SimonKohler88/esl1_fpga_fir/README.md

# esl1_fpga_fir
Configurable FIR for FPGA
