SimonKohler88/esl1_fpga_fir/hw/datasheets/pinout-modulo-esp.png

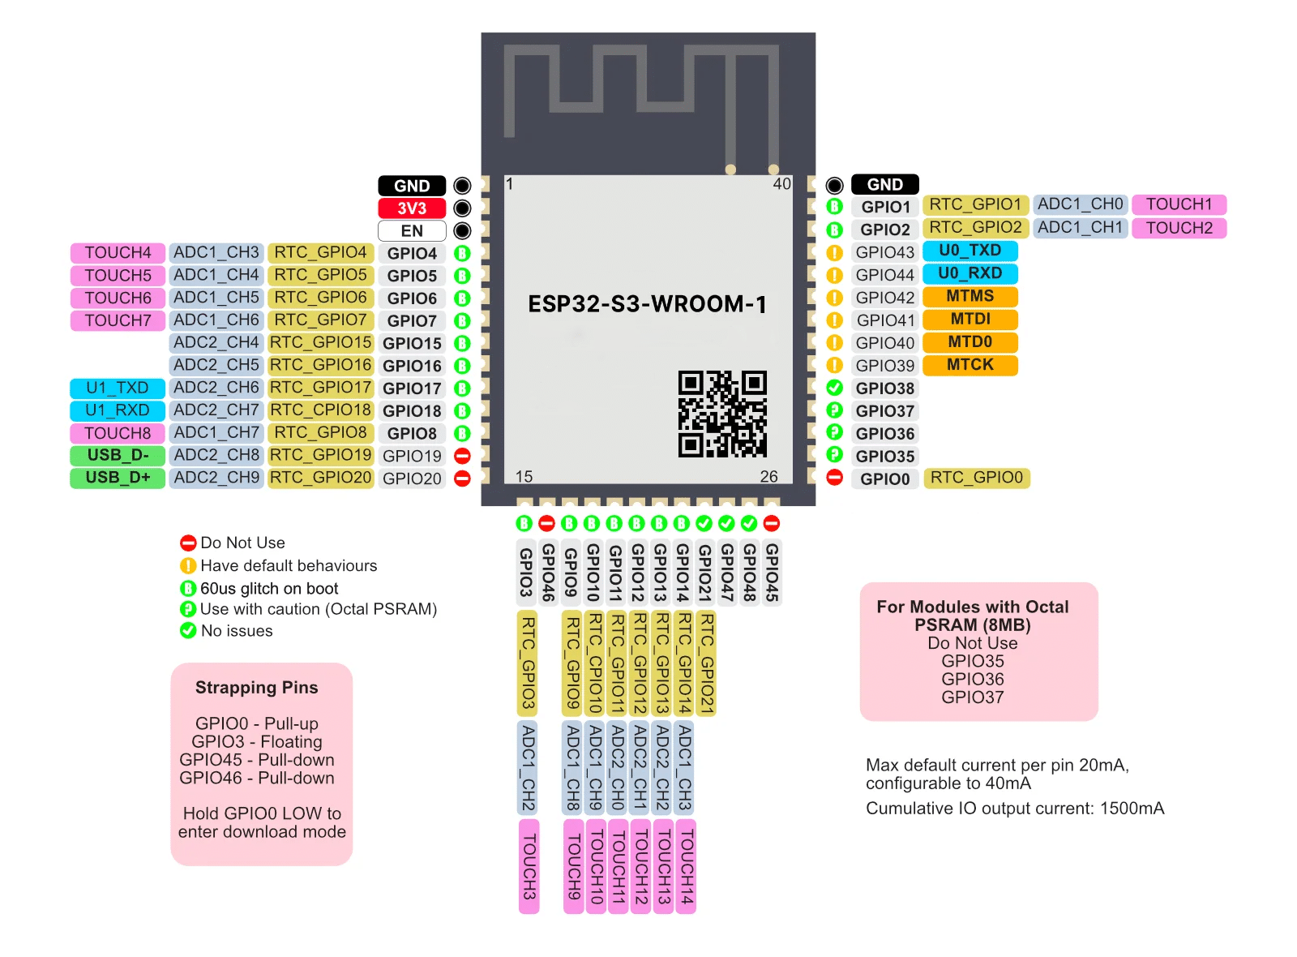
hw/datasheets/pinout-modulo-esp.png
