SimonKohler88/esl1_fpga_fir/pictures/Bode_3kHz_LP_FIR_Koeff.jpg

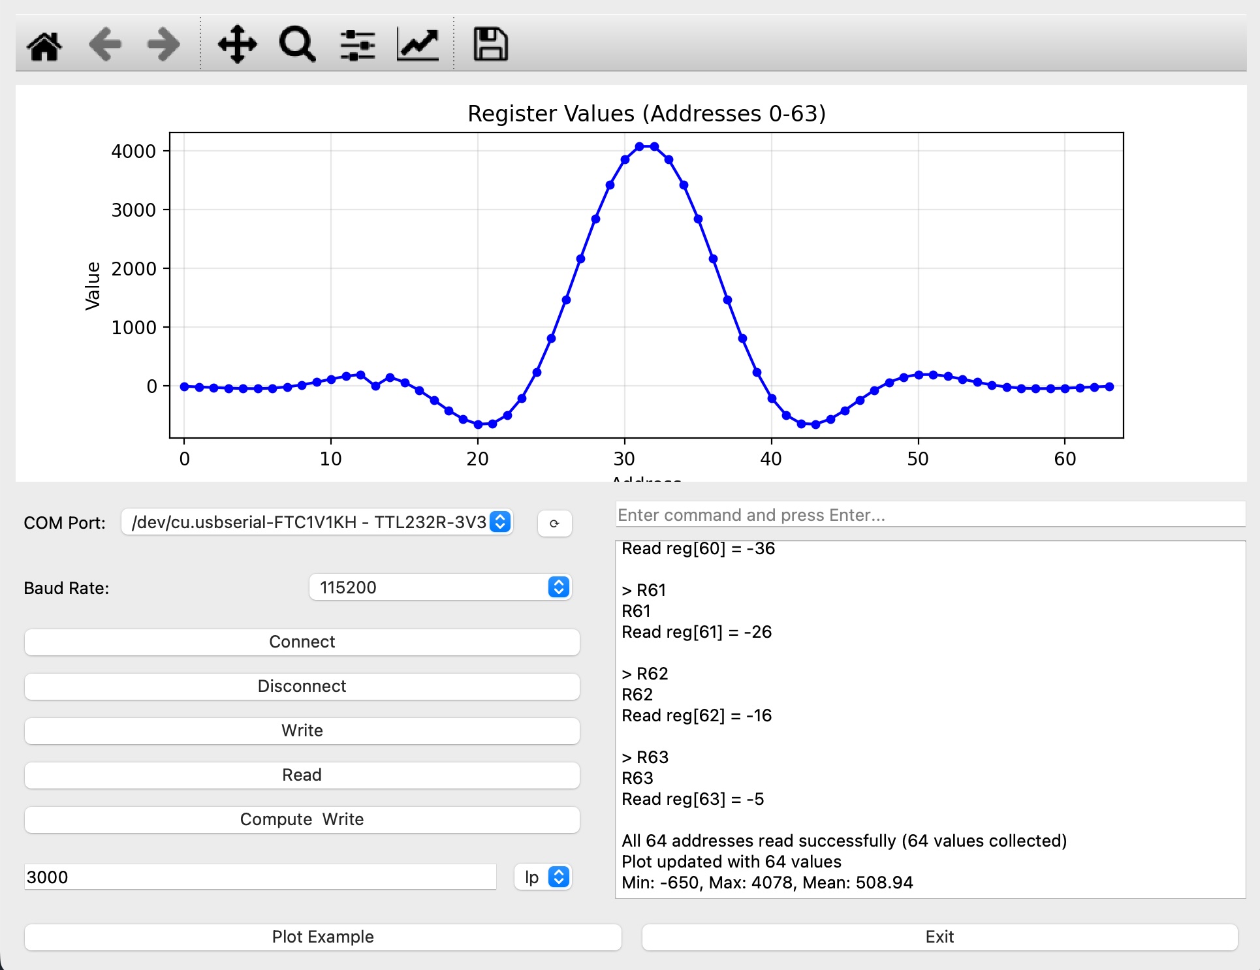
pictures/Bode_3kHz_LP_FIR_Koeff.jpg
