SimonKohler88/esl1_fpga_fir/pictures/Bode_10Hz_20kHz_2.png

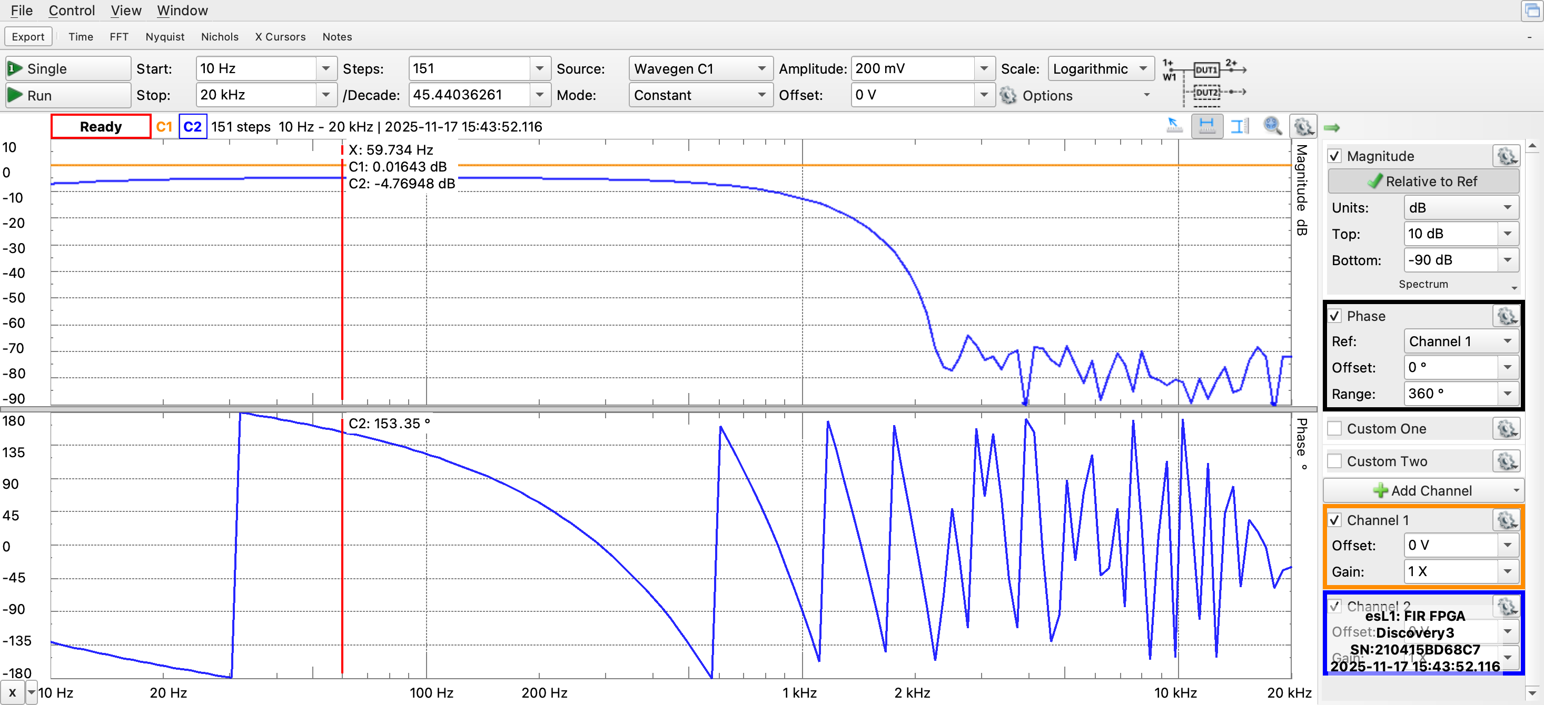
pictures/Bode_10Hz_20kHz_2.png
