SimonKohler88/esl1_fpga_fir/pictures/Bode_10Hz_20kHz_2_ FIR_Koeff.png

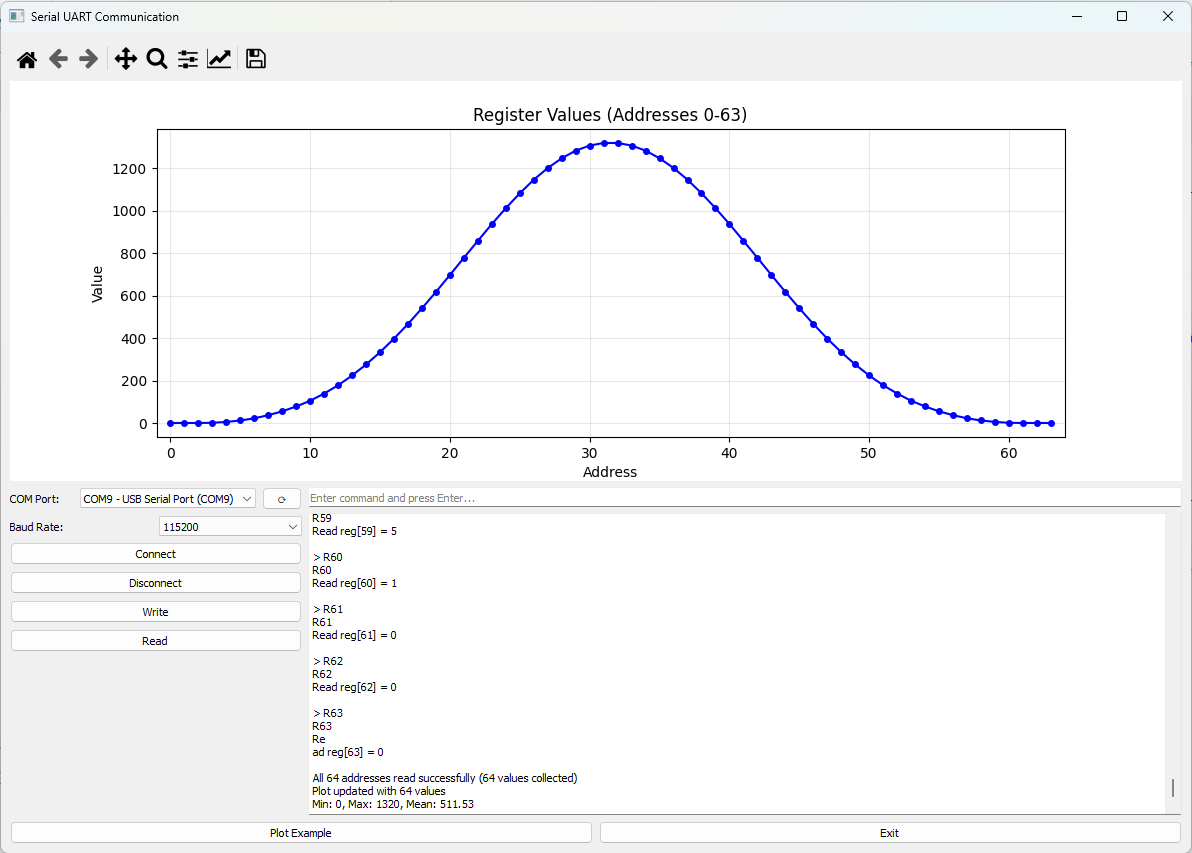
pictures/Bode_10Hz_20kHz_2_ FIR_Koeff.png
