SimonKohler88/esl1_fpga_fir/pictures/Coefficients_2kHz_LP.png

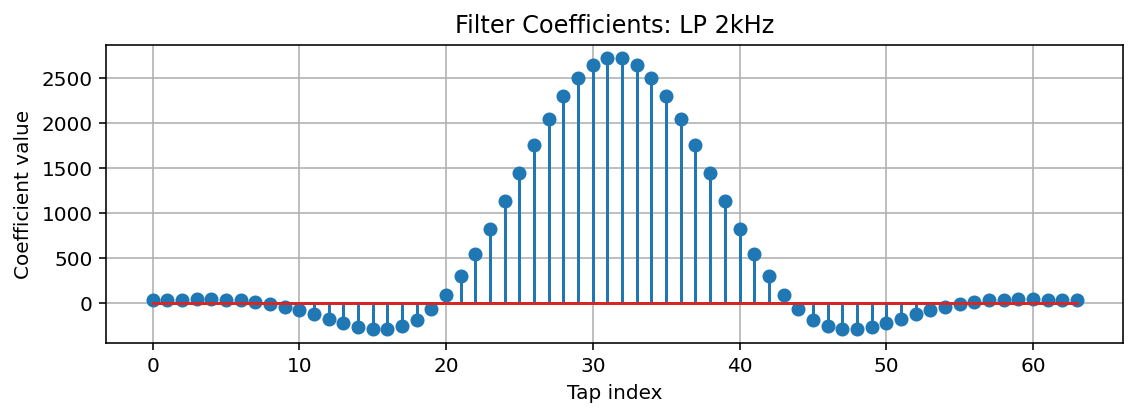
pictures/Coefficients_2kHz_LP.png
