SimonKohler88/esl1_fpga_fir/pictures/Coefficients_3kHz_LP.png

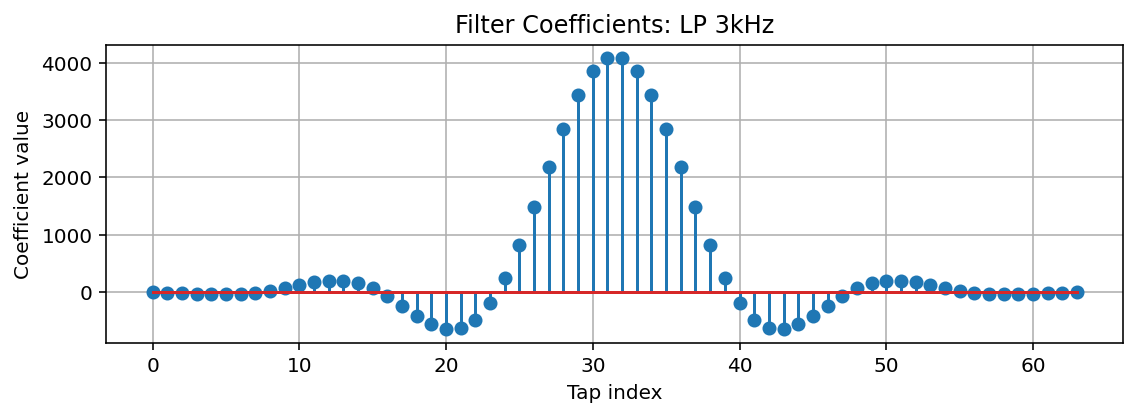
pictures/Coefficients_3kHz_LP.png
