SimonKohler88/esl1_fpga_fir/pictures/Magnitude_2kHz_LP.png

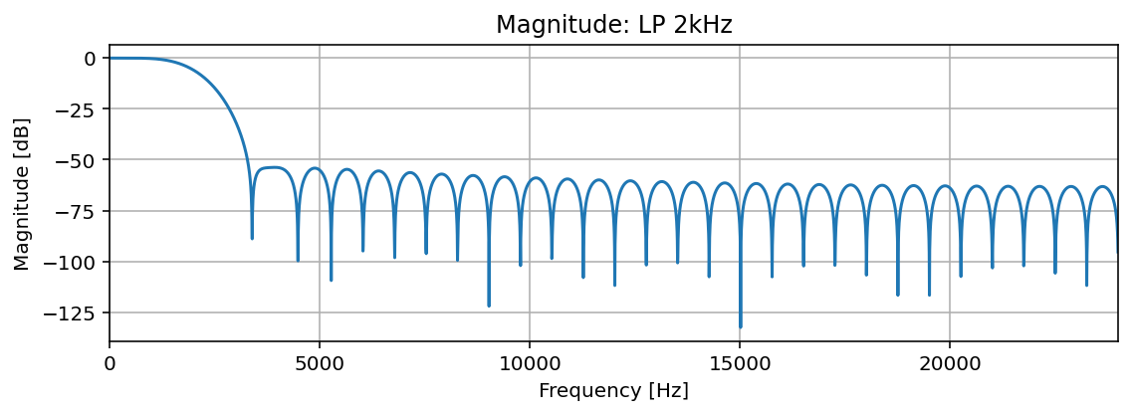
pictures/Magnitude_2kHz_LP.png
