SimonKohler88/esl1_fpga_fir/pictures/Magnitude_3kHz_LP.png

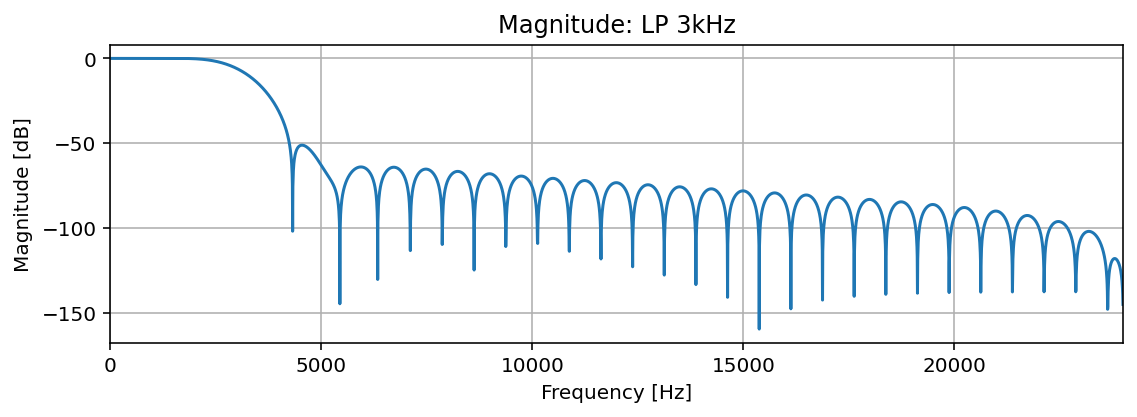
pictures/Magnitude_3kHz_LP.png
