SimonKohler88/esl1_fpga_fir/pictures/Phase_2kHz_LP.png

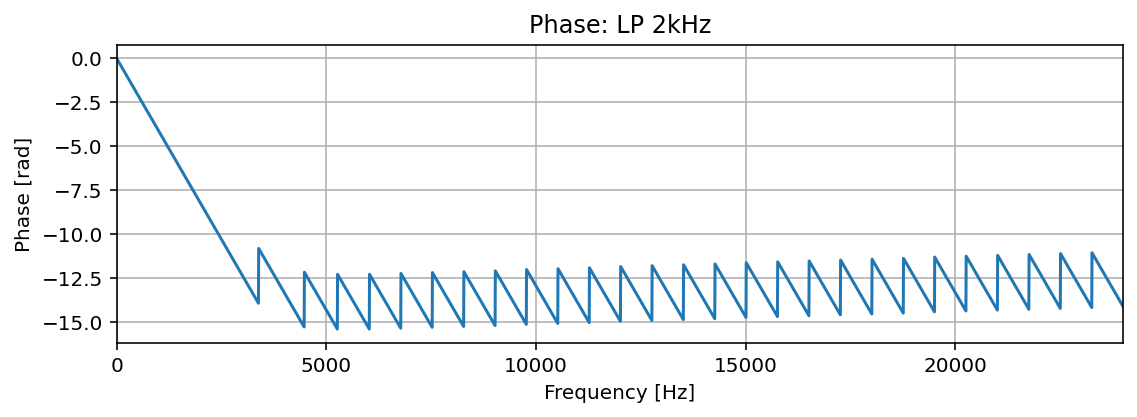
pictures/Phase_2kHz_LP.png
