SimonKohler88/esl1_fpga_fir/pictures/Phase_3kHz_LP.png

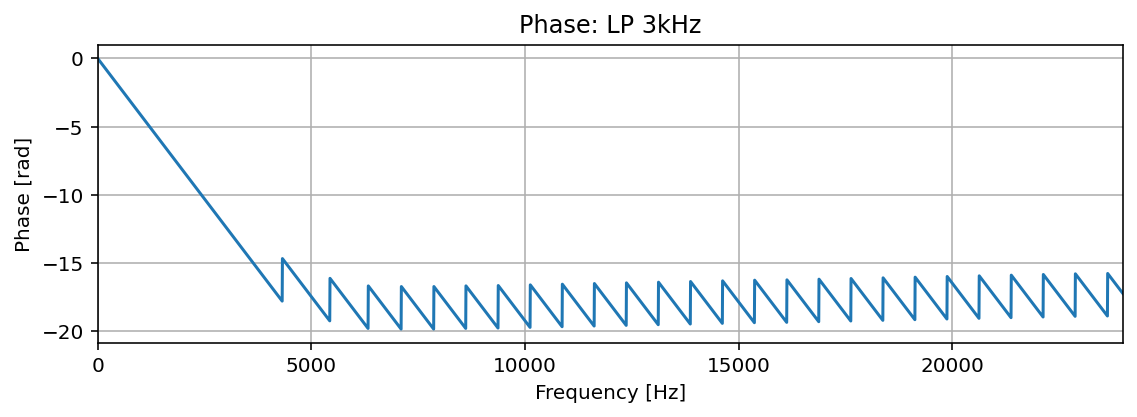
pictures/Phase_3kHz_LP.png
