SimonKohler88/esl1_fpga_fir/teros_doku/dependency_diagram.jpg

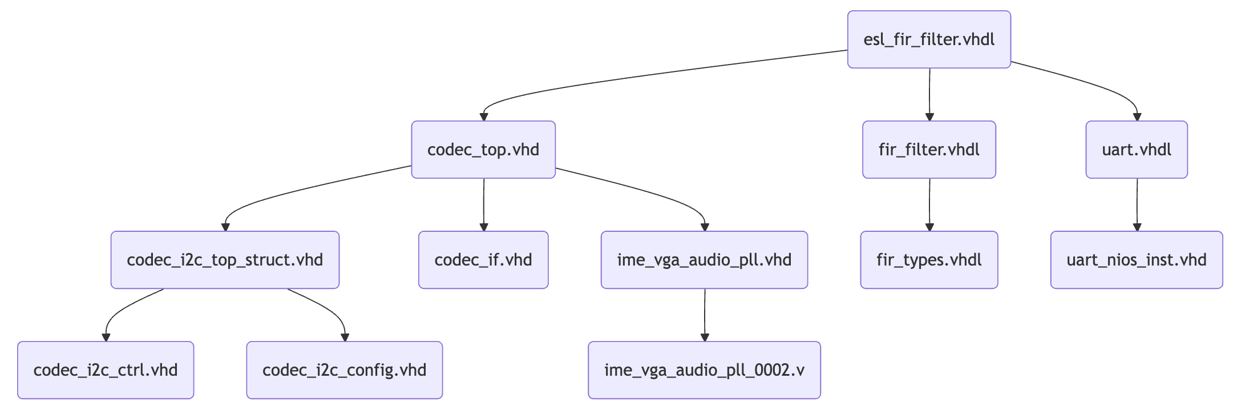
teros_doku/dependency_diagram.jpg
