SimonKohler88/esl1_fpga_fir/hw/kicad/bom.xlsx

 |  |  |  | Web | Anzahl
 | Dgikey | mouser
MCU | 5407-ESP32-S3-WROOM-1-N16CT-ND | 356-ESP32S3WROOM1N16 | ESP32-S3-WROOM-1-N16 | https://www.digikey.ch/de/products/detail/espressif-systems/ESP32-S3-WROOM-1-N16/16162647 | 1
ADC |  | 595-ADS7883SBDBVT | ADS7883 | https://www.mouser.ch/ProductDetail/Texas-Instruments/ADS7883SBDBVT?qs=iW8OfOTwbwNSwjtnxxv63g%3D%3D | 1
DAC |  | 926-DAC122S085CIMMNO | DAC122S085CIMMNO | https://www.mouser.ch/ProductDetail/Texas-Instruments/DAC122S085CIMM-NOPB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 | 1
inout opamp | 505-AD8671ARZ-ND | 584-AD8671ARZ-R7 | AD8671ARZ | https://www.digikey.ch/de/products/detail/analog-devices-inc/AD8671ARZ/751202 | 2
tp opamp | LM6134BIMX/NOPBCT-ND | 926-LM6134BIMX/NOPB | LM6134BIMX/NOPB | https://www.digikey.ch/de/products/detail/texas-instruments/LM6134BIMX-NOPB/334884 | 2
vref demux | NC7SB3157P6XCT-ND | 512-NC7SB3157P6X | NC7SB3157P6X | https://www.digikey.ch/de/products/detail/onsemi/NC7SB3157P6X/412875 | 1
komparator | 296-TLV9022DRCT-ND | 595-TLV9022DR | TLV9022DR | https://www.digikey.ch/de/products/detail/texas-instruments/TLV9022DR/13535468 | 1
mode mux | 296-14271-1-ND | 595-CD4051BM96 | CD4051BM96 | https://www.digikey.ch/de/products/detail/texas-instruments/CD4051BM96/528372 | 2
ref, ref2 | 296-47351-1-ND | 595-REF2030AIDDCR | REF2030AIDDCR | https://www.digikey.ch/de/products/detail/texas-instruments/REF2030AIDDCR/5004869 | 1
NT 12 -12V | 1866-3764-ND | 709-PD2512 | PD-2512 | https://www.digikey.ch/de/products/detail/mean-well-usa-inc/pd-2512/7705634 | 1
dcdc 12-->5 | 1866-N7805-1CW-ND | 709-N7805-1CW | N7805-1CW | https://www.digikey.ch/de/products/detail/mean-well-usa-inc/N7805-1CW/22119070 | 1 | oder
 |  |  | R-78W5.0-0.5 | https://www.digikey.ch/de/products/detail/recom-power/R-78W5-0-0-5/4930586 | 1
schalter | CH784-ND | 540-WRG32F2FBBNN | WRG32F2FBBNN | https://www.digikey.ch/de/products/detail/zf-electronics/WRG32F2FBBNN/446050 | 1
Taster | 108-D6C90F2LFS-ND | 611-D6C90F2LFS | D6C90 F2 LFS | https://www.digikey.ch/de/products/detail/c-k/D6C90-F2-LFS/1466345 | 2
usb buchse | 664-12402012E212ACT-ND | 523-12402012E212A | 12402012E212A | https://www.digikey.ch/de/products/detail/amphenol-icc-commercial-products/12402012E212A/13683192 | 1
usb tvs | 497-5235-1-ND | 511-USBLC6-2SC6 | USBLC6-2SC6 SOT-23-6L | https://www.digikey.ch/de/products/detail/stmicroelectronics/USBLC6-2SC6/1040559 | 1
encoder | PEC12R-4220F-S0024-ND | 652-PEC12R-4220F-S24 | PEC12R-4220F-S0024 | https://www.digikey.ch/de/products/detail/bourns-inc/PEC12R-4220F-S0024/4499653 | 1
coax | ARF2111-ND | 523-31-6575 | 031-6575 | https://www.digikey.ch/de/products/detail/amphenol-rf/031-6575/4037241 | 1
 |  |  | other: | https://www.digikey.ch/de/products/detail/amphenol-rf/031-5329-51RFX/2041813
flachbandstecker | S9171-ND | 649-75869-303LF | 2x8, P:2.54 | https://www.digikey.ch/de/products/detail/sullins-connector-solutions/SBH11-PBPC-D08-ST-BK/1990064 | 2
Gehäuse |  |  | aliex | https://de.aliexpress.com/item/1005008808386515.html
flachbandkabel |  |  | aliex | https://de.aliexpress.com/item/1005004762590129.html?curPageLogUid=rxgwr2OguP4N
 |  |  |  | https://de.aliexpress.com/item/1005008653256671.html?curPageLogUid=nA8Mu69b0s12
