SimonKohler88/esl1_fpga_fir/hw/kicad/Warenkorb_Mouser.xls

WARENKORB
Dies ist keine Rechnung
15-Feb-26 05:59:57
 | Mouser-Nr. | Herst.- Nr. | Hersteller | Kunden-Teilenr | Beschreibung | RoHS | Lebenszyklus | Stückzahl | Preis (CHF) | Gesamtpreis: (CHF)
1 | 595-ADS7883SBDBVT | ADS7883SBDBVT | Texas Instruments |  | Analog to Digital Converters - ADC 2.7V-5.5V 12B 3MSPS Serial ADC A 595-ADS A 595-ADS7883SBDBVR | RoHS-konform |  | 1 | CHF 5.12 | CHF 5.12
2 | 356-ESP32S3WROOM1N16 | ESP32-S3-WROOM-1-N16 | Espressif |  | Multiprotokoll-Module SMD module, ESP32-S3, 16 MB SPI flash, PCB antenna | RoHS-konform |  | 1 | CHF 4.85 | CHF 4.85
3 | 926-DAC122S085CIMMNO | DAC122S085CIMM/NOPB | Texas Instruments |  | Digital to Analog Converters - DAC 12B MICRO PWR DUAL D AC A 926-D122S085CI A 926-D122S085CIMMXNPB | RoHS-konform |  | 1 | CHF 4.65 | CHF 4.65
4 | 584-AD8671ARZ-R7 | AD8671ARZ-REEL7 | Analog Devices Inc. |  | Präzisionsverstärker SINGLE PRECISION LOW NOISE BIPOLAR AMP | RoHS-konform |  | 2 | CHF 4.73 | CHF 9.46
5 | 926-LM6134BIMX/NOPB | LM6134BIMX/NOPB | Texas Instruments |  | Operationsverstärker QUAD LOW POWER 10 MH Z RRIO OP AMP A 926 A 926-LM6134BIM/NOPB | RoHS-konform |  | 2 | CHF 3.65 | CHF 7.30
6 | 512-NC7SB3157P6X | NC7SB3157P6X | onsemi |  | Analogschalter IC Low Voltage UHS SPDT Analog Switch | RoHS-konform |  | 1 | CHF 0.178 | CHF 0.18
7 | 595-TLV9022DR | TLV9022DR | Texas Instruments |  | Analoge Komparatoren Dual precision compa rator with open-dra | RoHS-konform |  | 1 | CHF 1.26 | CHF 1.26
8 | 595-CD4051BM96 | CD4051BM96 | Texas Instruments |  | Multiplex-Schalter IC 8-Channel Analog A 5 95-CD4051BM A 595-C A 595-CD4051BM | RoHS-konform |  | 2 | CHF 0.454 | CHF 0.91
9 | 595-REF2030AIDDCR | REF2030AIDDCR | Texas Instruments |  | Spannungsreferenzen Low-Drift Lw-Pwr Du al Output Volt Ref A A 595-REF2030AIDDCT | RoHS-konform |  | 1 | CHF 2.97 | CHF 2.97
10 | 709-PD2512 | PD-2512 | MEAN WELL |  | Netzteile – Gehäusemontage 24W 12V/1A -12V/1A | RoHS-konform |  | 1 | CHF 12.15 | CHF 12.15
11 | 709-N7805-1CW | N7805-1CW | MEAN WELL |  | Schaltspannungsregler 8-36Vi;5Vo/0.5-1A;Casing with Wire | RoHS-konform |  | 1 | CHF 4.23 | CHF 4.23
12 | 540-WRG32F2FBBNN | WRG32F2FBBNN | ZF Electronics |  | Wippschalter DPST BLK 16A ON-OFF | RoHS-konform |  | 1 | CHF 1.36 | CHF 1.36
13 | 611-D6C90F2LFS | D6C90 F2 LFS | C&K Switches |  | Drucktastenschalter Key Switch N.O. SPDT 100 mA | RoHS-konform |  | 2 | CHF 1.11 | CHF 2.22
14 | 523-12402012E212A | 12402012E212A | Amphenol |  | USB-Stecker USB2.0 GEN1, F C VT DUAL SMT | RoHS-konform |  | 1 | CHF 0.576 | CHF 0.58
15 | 511-USBLC6-2SC6 | USBLC6-2SC6 | STMicroelectronics |  | ESD-Schutzdioden / TVS-Dioden ESD Protection Low Cap | RoHS-konform |  | 1 | CHF 0.292 | CHF 0.29
16 | 652-PEC12R-4220F-S24 | PEC12R-4220F-S0024 | Bourns |  | Encoder HORZ 24DET 24PULSE 20mm SHAFT SPST SW | RoHS: Konform durch Ausnahmegenehmigung |  | 1 | CHF 1.38 | CHF 1.38
17 | 523-31-6575 | 031-6575 | Amphenol |  | RF-Steckverbinder/Koaxial-Steckverbinder BNC RA Double ISOL Black 50 OHM Valox | RoHS: Konform durch Ausnahmegenehmigung |  | 1 | CHF 8.23 | CHF 8.23
18 | 649-75869-303LF | 75869-303LF | Amphenol |  | Sockel & Kabelgehäuse 16P DR VERT SHRD HDR .38 GOLD | RoHS-konform |  | 2 | CHF 1.13 | CHF 2.26
Durch das Absenden Ihrer Bestellung erklären Sie sich mit diesen Geschäftsbedingungen einverstanden. (https://www.mouser.ch/saleterms) |  |  |  |  |  |  |  |  | Ware: | CHF 65.92
Die Preise sind zum angezeigten Datum und zur Uhrzeit reflektiert. |  |  |  |  |  |  |  |  | Versandkosten: | CHF 0.00
