SimonKohler88/esl1_fpga_fir/hw/freecad/layout.FCStd

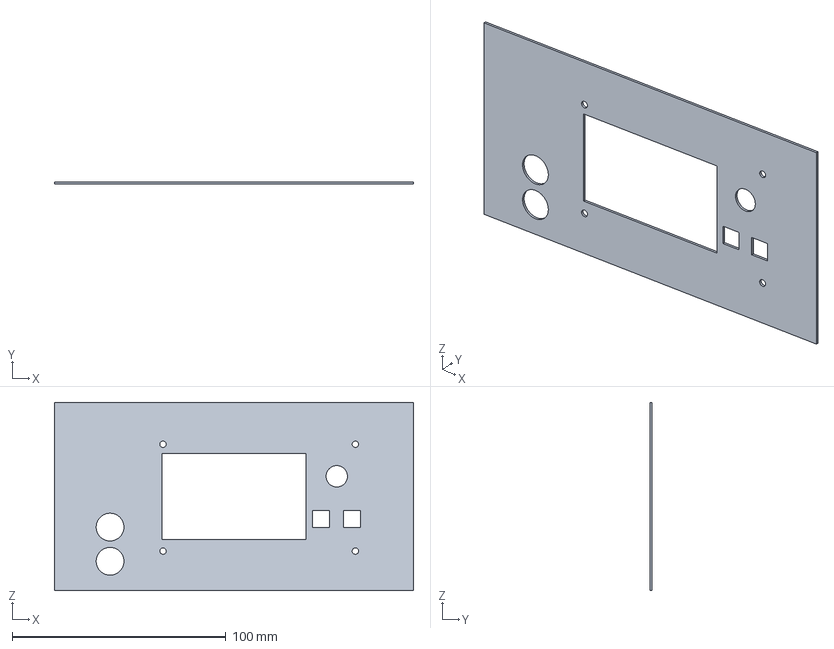
[picture p15: CAD file, 2026-02-25]
hw/freecad/layout.FCStd
168.0 x 1.00 x 88.0 mm
