SimonKohler88/esl1_fpga_fir/hw/kicad/symbols/ul_031-6575/31-6575.stp

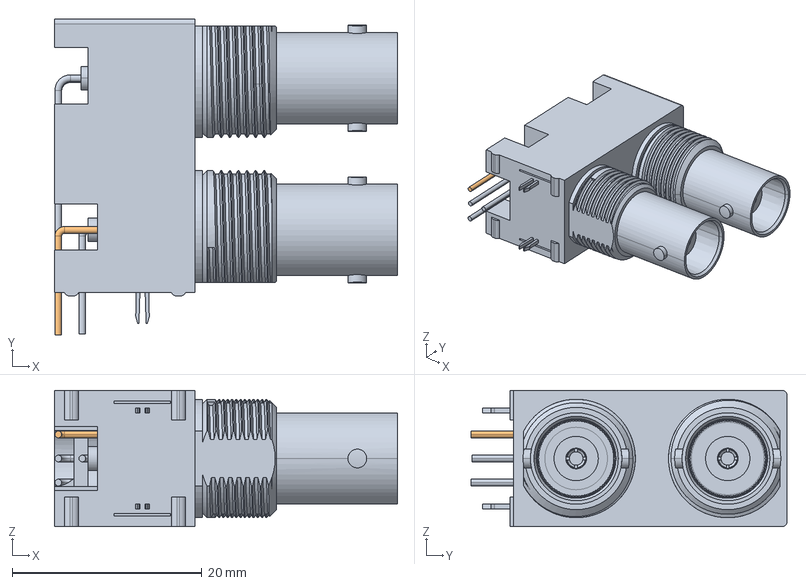
[picture p16: CAD file, 2026-02-25]
hw/kicad/symbols/ul_031-6575/31-6575.stp
36.2 x 33.4 x 14.4 mm
