SimonKohler88/esl1_fpga_fir/hw/kicad/symbols/ul_AD8671ARZ/R_8_ADI.step

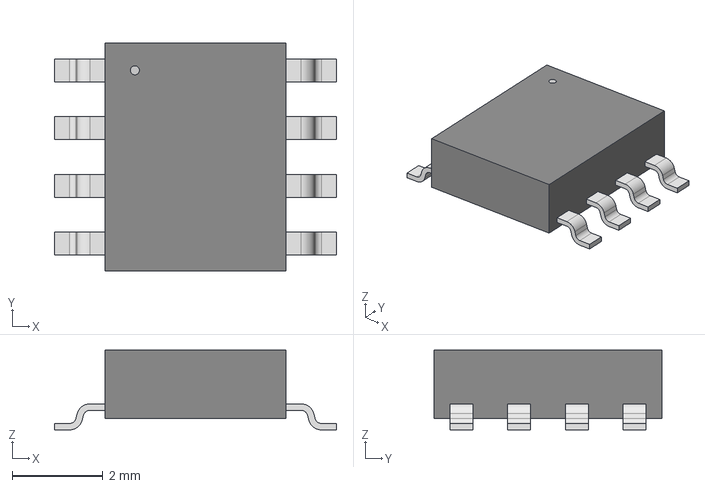
[picture p17: CAD file, 2026-02-25]
hw/kicad/symbols/ul_AD8671ARZ/R_8_ADI.step
6.20 x 5.00 x 1.75 mm
