SimonKohler88/esl1_fpga_fir/hw/kicad/symbols/ul_ADS7883SBDBVT/DBV0006A.stp

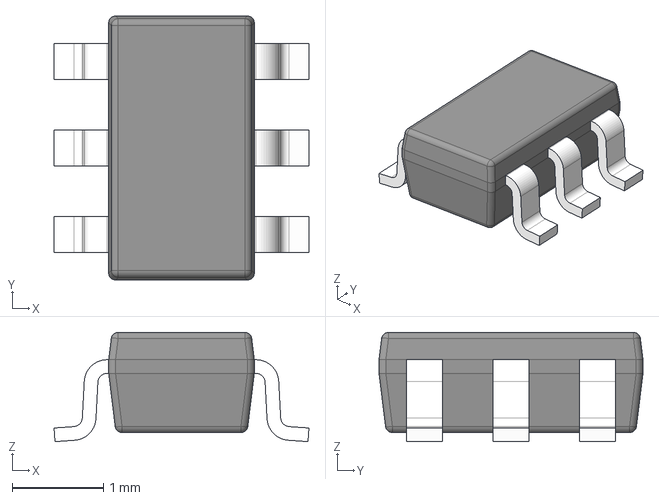
[picture p18: CAD file, 2026-02-25]
hw/kicad/symbols/ul_ADS7883SBDBVT/DBV0006A.stp
2.80 x 2.90 x 1.20 mm
BODY-SOT
LEAD-SOT x 6
