SimonKohler88/esl1_fpga_fir/hw/kicad/symbols/ul_DAC121S101CIMKX-NOPB/DDC0006A.stp

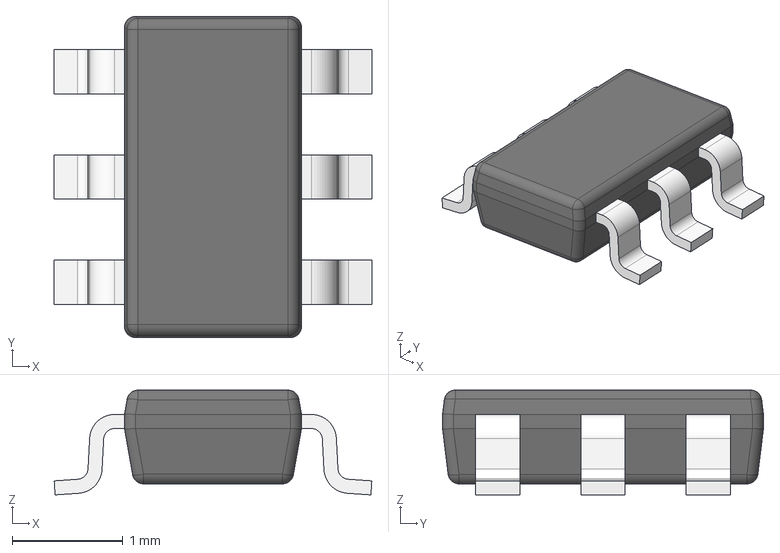
[picture p19: CAD file, 2026-02-25]
hw/kicad/symbols/ul_DAC121S101CIMKX-NOPB/DDC0006A.stp
2.87 x 2.90 x 0.947 mm
BODY-SOT
LEAD-SOT x 6
