SimonKohler88/esl1_fpga_fir/hw/kicad/symbols/ul_DAC122S085CIMM-NOPB/DGS0010A.stp

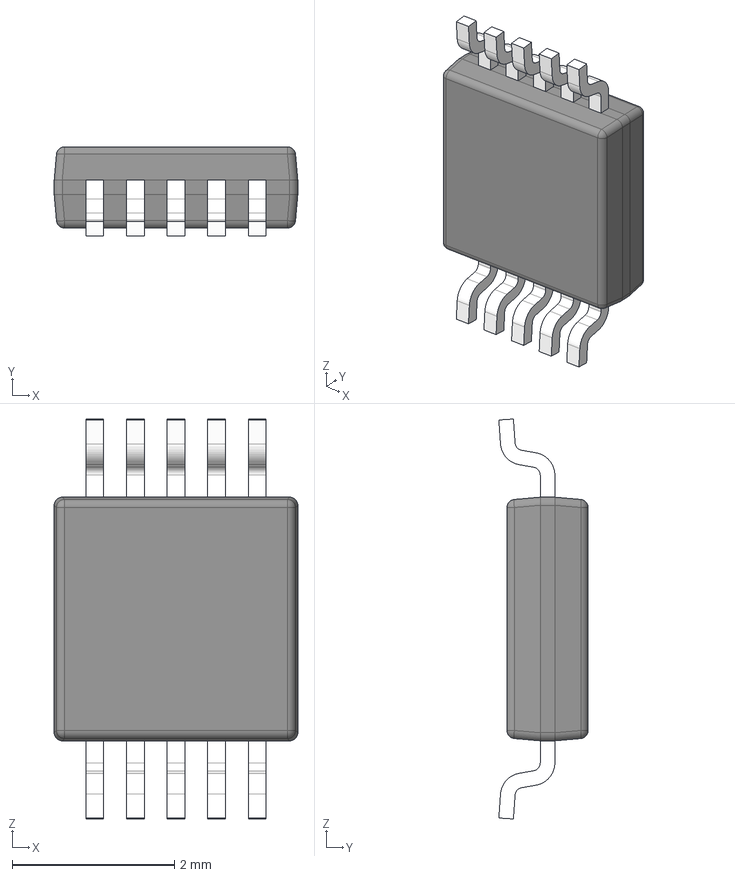
[picture p20: CAD file, 2026-02-25]
hw/kicad/symbols/ul_DAC122S085CIMM-NOPB/DGS0010A.stp
3.00 x 1.10 x 4.93 mm
BODY-SO
LEAD-SO x 10
PIN1-ID
