SimonKohler88/esl1_fpga_fir/hw/kicad/symbols/ul_LM6132AIMX-NOPB/D0008A.stp

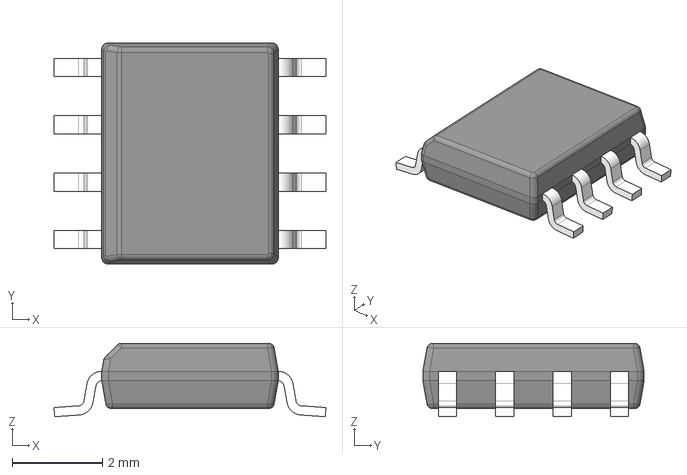
[picture p21: CAD file, 2026-02-25]
hw/kicad/symbols/ul_LM6132AIMX-NOPB/D0008A.stp
6.02 x 4.90 x 1.63 mm
BODY-SO
LEAD-D0008A x 8
