SimonKohler88/esl1_fpga_fir/hw/kicad/symbols/ul_LM6134BIMX-NOPB/D0014A.stp

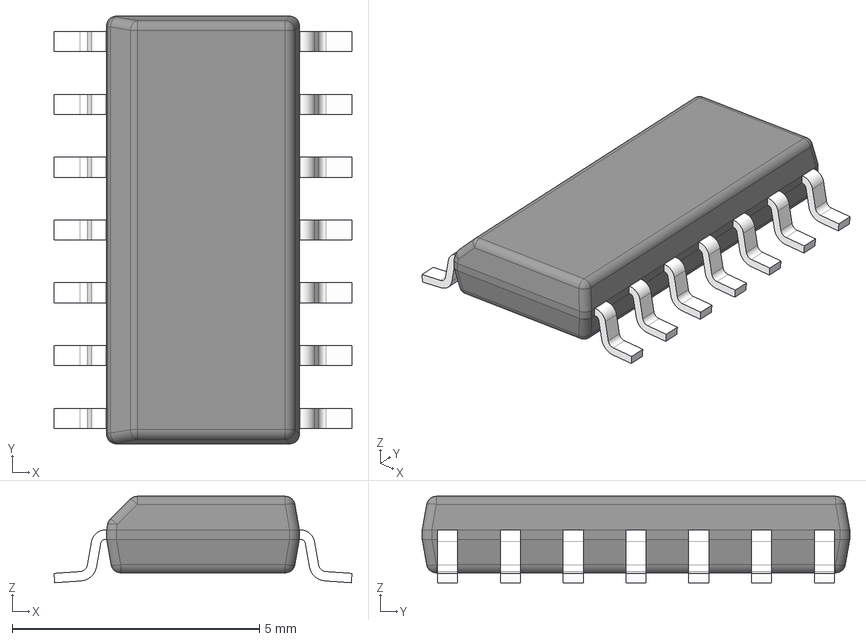
[picture p22: CAD file, 2026-02-25]
hw/kicad/symbols/ul_LM6134BIMX-NOPB/D0014A.stp
6.03 x 8.65 x 1.75 mm
BODY-SO
LEAD-SO x 14
PIN1-ID
