SimonKohler88/esl1_fpga_fir/hw/kicad/symbols/ul_USBLC6-2SC6/SOT23-6L_STM.step

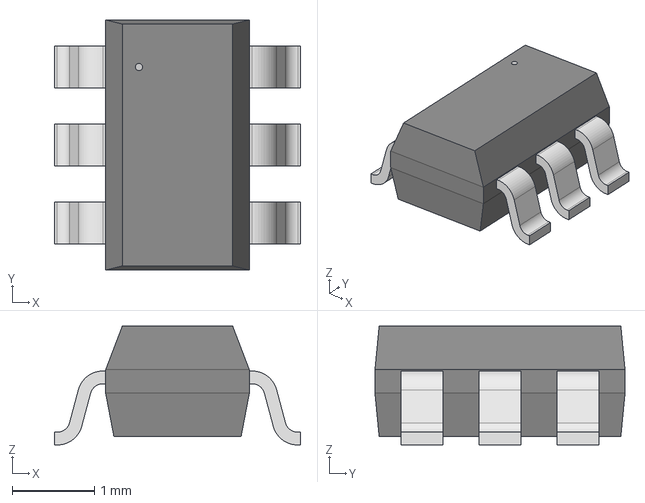
[picture p23: CAD file, 2026-02-25]
hw/kicad/symbols/ul_USBLC6-2SC6/SOT23-6L_STM.step
3.00 x 3.05 x 1.45 mm
