SimonKohler88/esl1_fpga_fir/hw/simulation/tp_reconstruction.asc

C1: cap; 470p
C2: cap; 800p
C3: cap; 1n
C5: cap; 1n
C6: cap; 68p
C7: cap; 1n
R1: res; 160
R2: res; 360
R3: res; 120
R4: res; 240
R5: res; 470
R6: res; 820
R8: res; 100k
R9: res; 400k
R11: res; 100
R12: res; 100
U1: UniversalOpAmp
U2: UniversalOpAmp
U3: UniversalOpAmp
U4: UniversalOpAmp
U5: UniversalOpAmp
V1: voltage; 3
V2: voltage; SINE(1.5 1.5 50 0 0 0 1000)
V3: voltage; 0.75
V4: voltage; 12
V5: voltage; 12
Named nets: 0, 3V, 1.5V, 12V, -12V
.tran 1
R          Range           Offset
200k   -3...3                 yes
333k   -5....5                yes
166k      0....5                no
400k    0...12              no
800k  -12....12            yes
100k   -1.5...1.5            yes
            0 ....3               no
