SimonKohler88/esl1_fpga_fir/hw/simulation/Draft1.asc

C1: cap; 3.3n
C2: cap; 1.5n
R1: res; 100k
R2: res; 200k
U1: OP27
V1: voltage; 5
V2: voltage; 5
V3: voltage; ac 1
Named nets: 0, 5V, -5V, out, in
.ac dec 10 1 10k
