SimonKohler88/esl1_fpga_fir/hw/simulation/tp_antialiasing.asc

C1: cap; 470p
C2: cap; 800p
C3: cap; 1n
C4: cap; 470p
C5: cap; 1n
C6: cap; 68p
C7: cap; 1n
D1: zener; BZX84C6V2L
D2: zener; BZX84C6V2L
D3: zener; BZX84C12L
D4: zener; BZX84C12L
R1: res; 160
R2: res; 360
R3: res; 120
R4: res; 240
R5: res; 470
R6: res; 820
R7: res; 100
R8: res; 10k
R9: res; 10k
R11: res; 100
R12: res; 100
U1: UniversalOpAmp
U2: UniversalOpAmp
U3: UniversalOpAmp
U4: UniversalOpAmp
U5: UniversalOpAmp
U6: LTC6253
V1: voltage; 3
V2: voltage; SINE(0 12 50 0 0 0 1000); AC AC 1
V3: voltage; 0.75
V4: voltage; 12
V5: voltage; 12
Named nets: 0, 3V, 1.5V, 12V, -12V
.ac dec 10 1 10Meg
R          Range           Offset
5k0   -3...3                 yes
3k0   -5....5                yes
6k      0....5                no
2k5    0...12              no
1k25   -12....12            yes
10k   -1.5...1.5            yes
           0 ....3               no
