SimonKohler88/esl1_fpga_fir/hw/kicad/v1/v1_frontpanel/v1_frontpanel.kicad_pcb

## KiCad design hw/kicad/v1/v1_frontpanel/v1_frontpanel.kicad_pcb (2026-03-26)

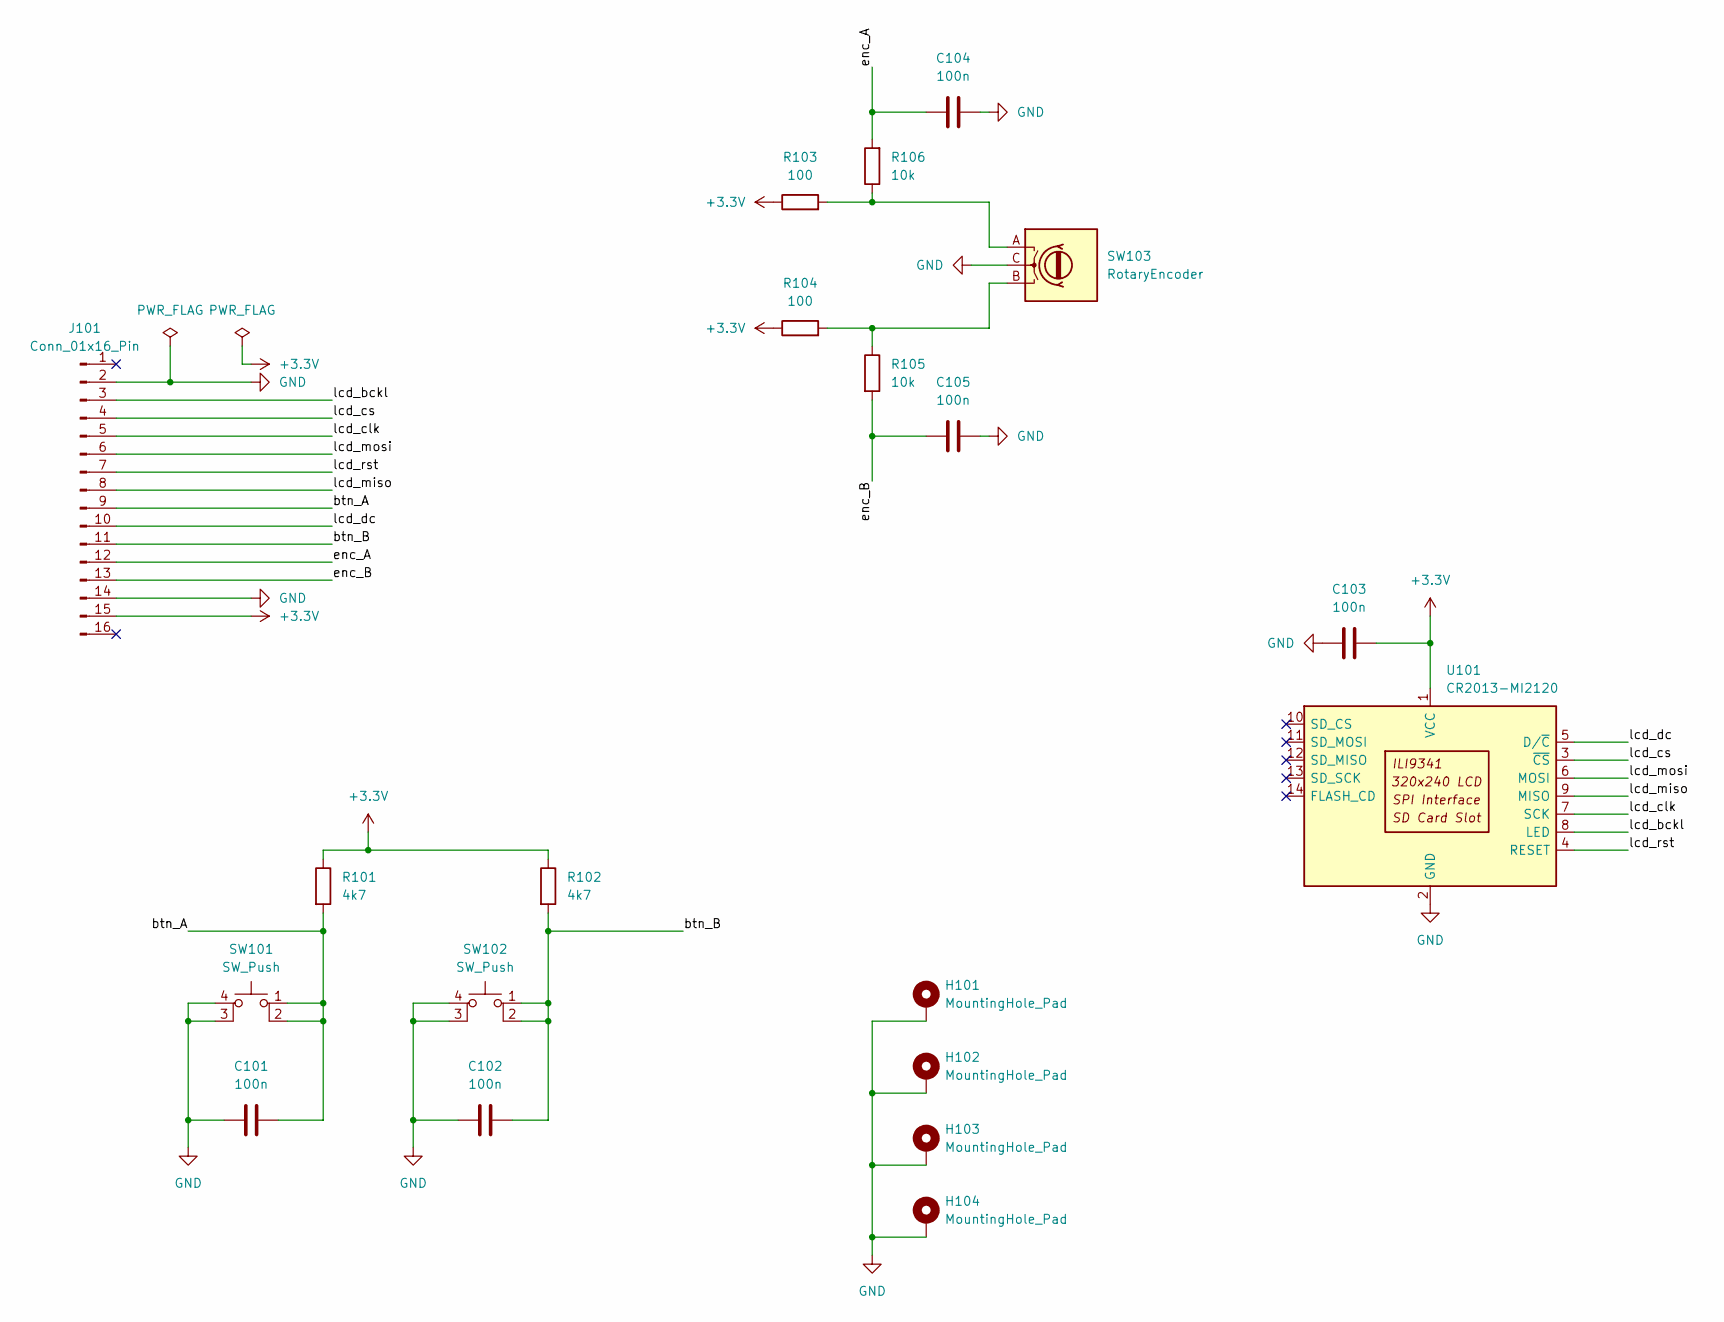
[picture p24: schematic v1_frontpanel.kicad_sch]

Parts:
C101, C102, C103, C104, C105: 100n; C_1206_3216Metric_Pad1.33x1.80mm_HandSolder
H101, H102, H103, H104: MountingHole_Pad; MountingHole_3.2mm_M3_DIN965_Pad
J101: Conn_01x16_Pin; PinHeader_2x08_P2.54mm_Vertical
R101, R102: 4k7; R_1206_3216Metric_Pad1.30x1.75mm_HandSolder
R103, R104: 100; R_1206_3216Metric_Pad1.30x1.75mm_HandSolder
R105, R106: 10k; R_1206_3216Metric_Pad1.30x1.75mm_HandSolder
SW101, SW102: SW_Push; Push_E-Switch_KS01Q01
SW103: RotaryEncoder; RotaryEncoder_Bourns_Vertical_PEC12R-3x17F-Nxxxx
U101: CR2013-MI2120

Connections:
+3.3V: C103.1, J101.15, R101.1, R102.1, R103.1, R104.1, U101.1 (VCC)
/btn_A: C101.2, J101.9, R101.2, SW101.1, SW101.2
/btn_B: C102.2, J101.11, R102.2, SW102.1, SW102.2
/enc_A: C104.2, J101.12, R106.2
/enc_B: C105.1, J101.13, R105.2
/lcd_bckl: J101.3, U101.8 (LED)
/lcd_clk: J101.5, U101.7 (SCK)
/lcd_cs: J101.4, U101.3 (~CS)
/lcd_dc: J101.10, U101.5 (D/~C)
/lcd_miso: J101.8, U101.9 (MISO)
/lcd_mosi: J101.6, U101.6 (MOSI)
/lcd_rst: J101.7, U101.4 (RESET)
GND: C101.1, C102.1, C103.2, C104.1, C105.2, H101.1, H102.1, H103.1, H104.1, J101.2, J101.14, SW101.3 (K), SW101.4 (A), SW102.3 (K), SW102.4 (A), SW103.C, U101.2 (GND)
unnamed: R103.2, R106.1, SW103.A
unnamed: R104.2, R105.1, SW103.B

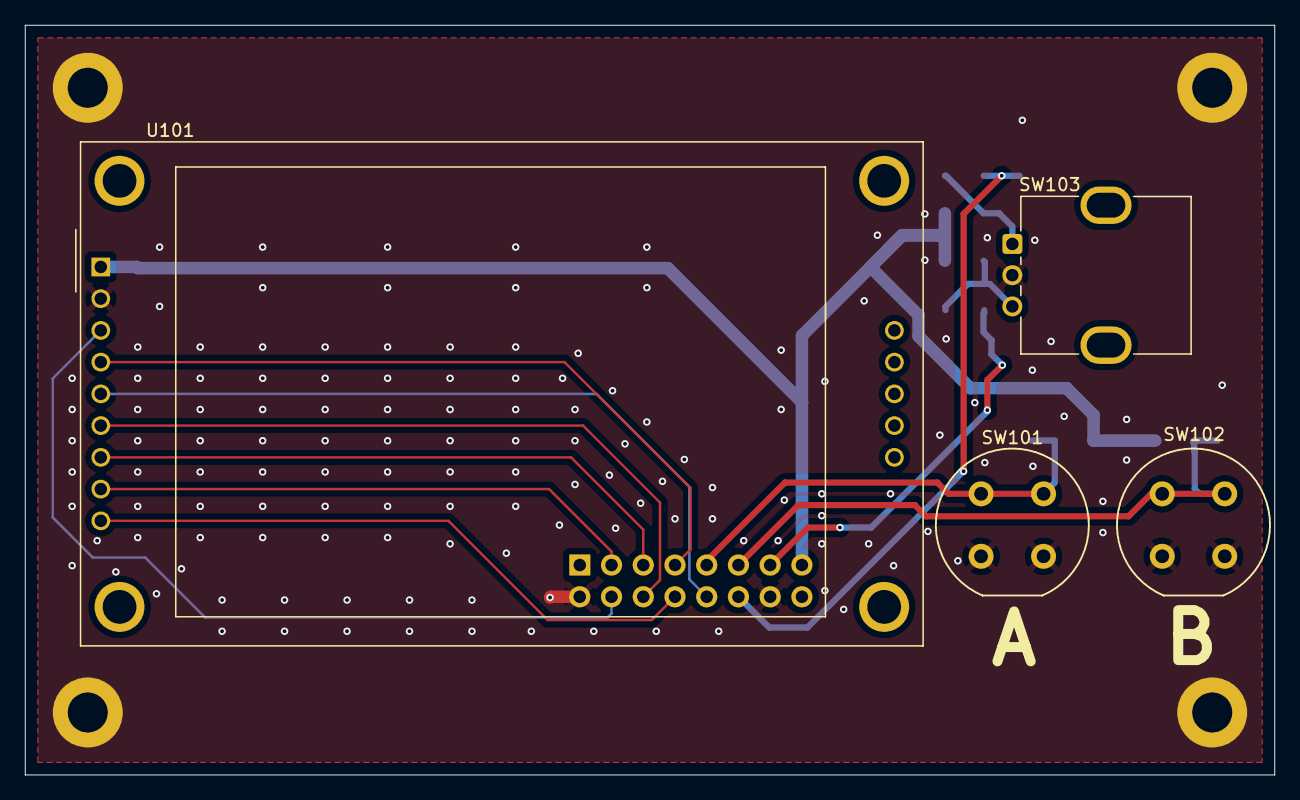
[picture p25: board v1_frontpanel.kicad_pcb from above]

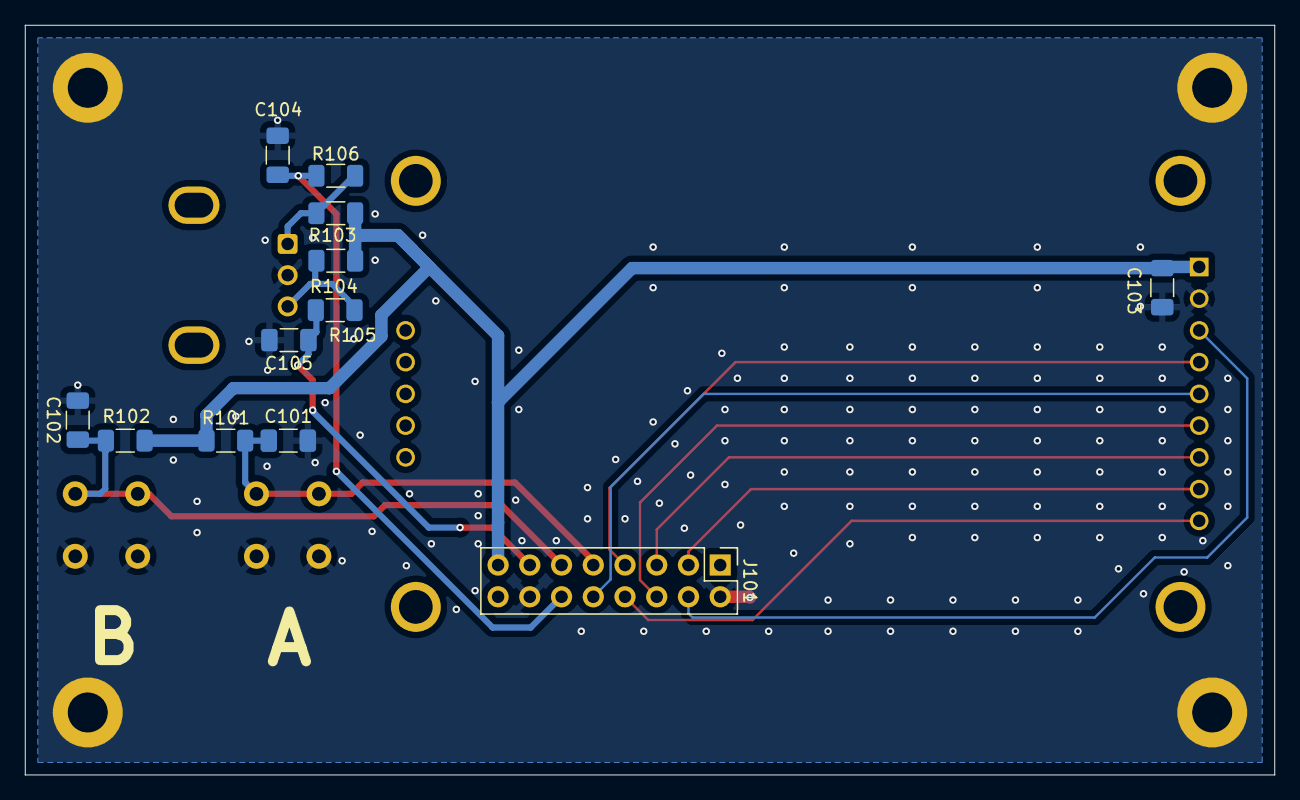
[picture p26: board v1_frontpanel.kicad_pcb from below]

Board: 2 copper layers, 100.0 x 60.0 mm, 20 parts (12 on the bottom side), 15 nets.
