SimonKohler88/esl1_fpga_fir/hw/kicad/v1/v1.kicad_pcb

## KiCad design hw/kicad/v1/v1.kicad_pcb (2026-03-26)

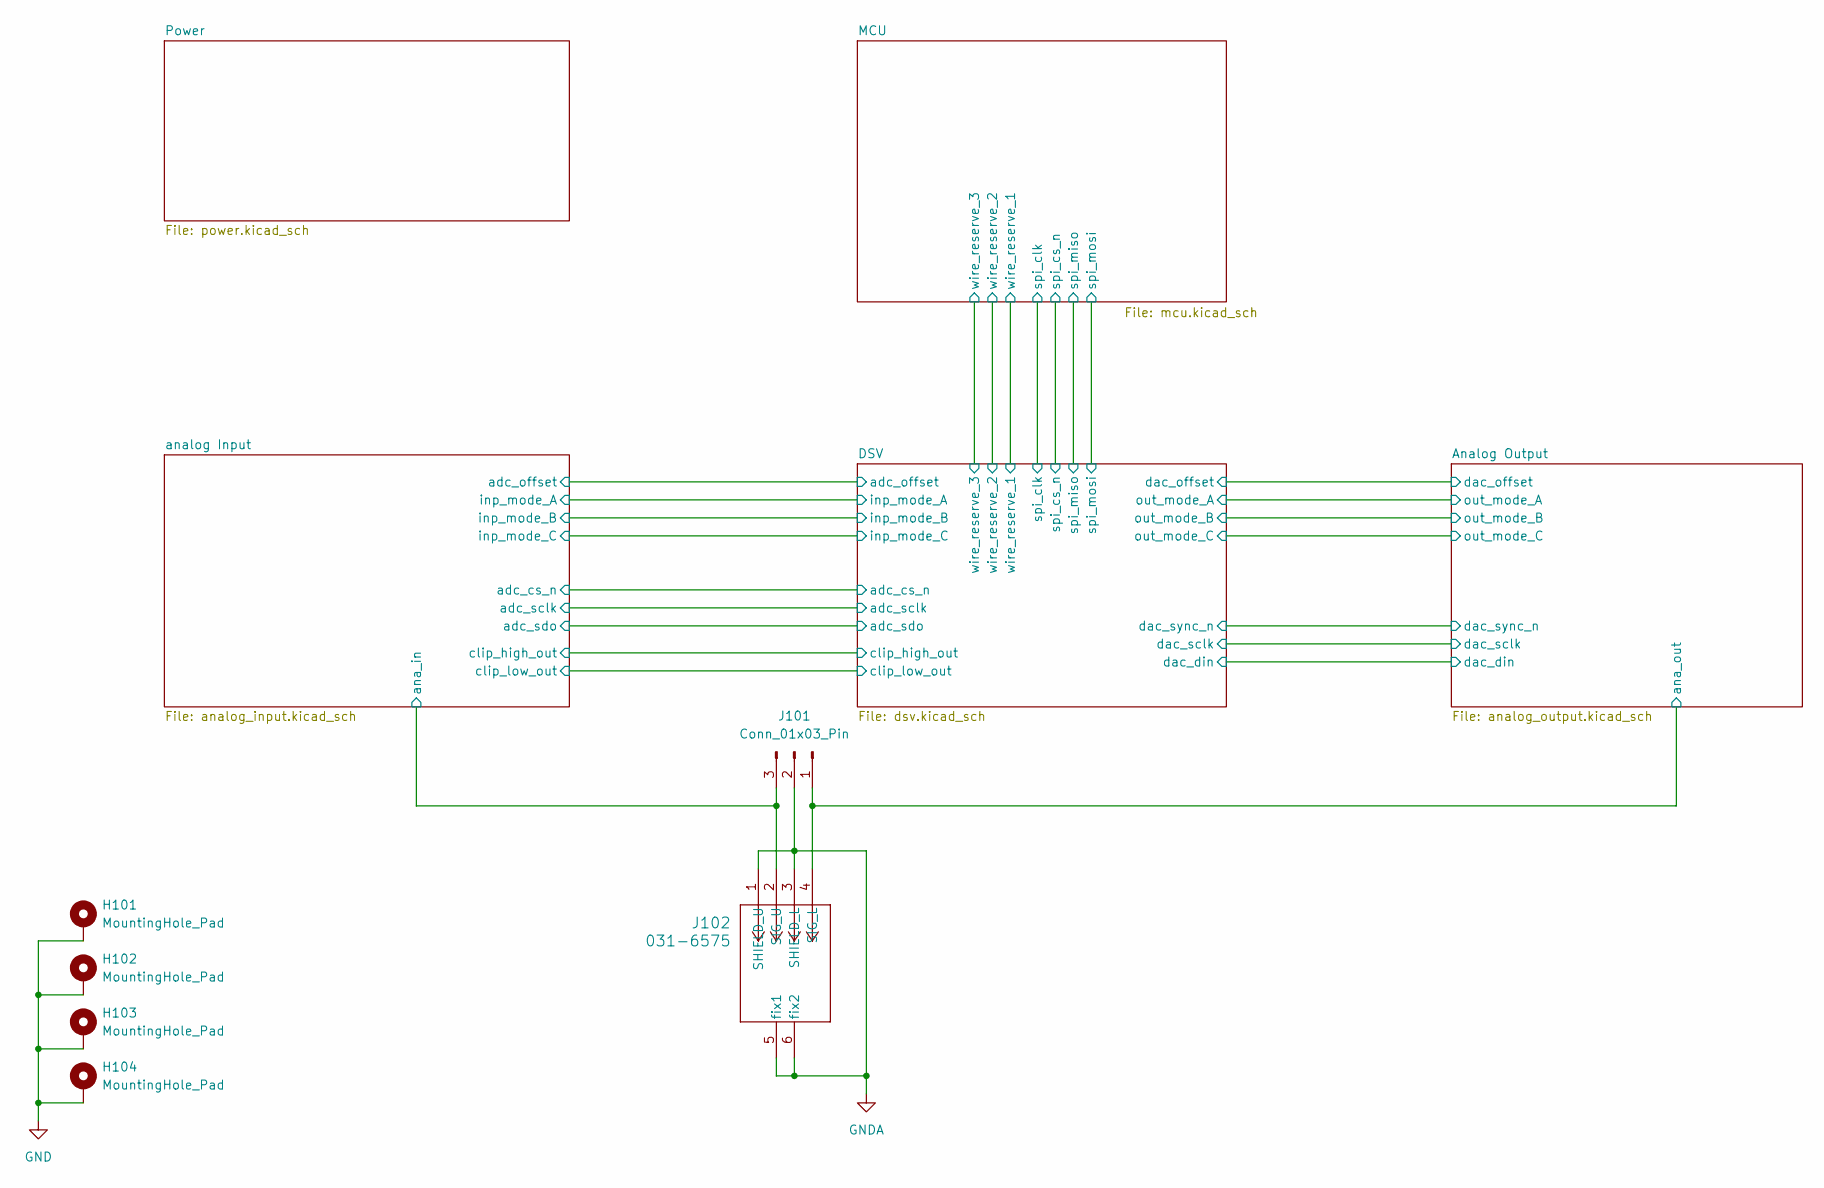
[picture p27: schematic v1.kicad_sch, FIR]

Parts:
H101, H102, H103, H104: MountingHole_Pad; MountingHole_3.2mm_M3_ISO7380_Pad_TopBottom
J101: Conn_01x03_Pin; PinHeader_1x03_P2.54mm_Horizontal
J102: 031-6575; CONN_6575_AMP

Connections:
/Analog Output/ana_out: J101.1, J102.4 (SIG_L); also elsewhere on the board
/analog Input/ana_in: J101.3, J102.2 (SIG_U); also elsewhere on the board
GND: H101.1, H102.1, H103.1, H104.1, J101.2, J102.1 (SHIELD_U), J102.3 (SHIELD_L), J102.5 (fix1), J102.6 (fix2); also elsewhere on the board

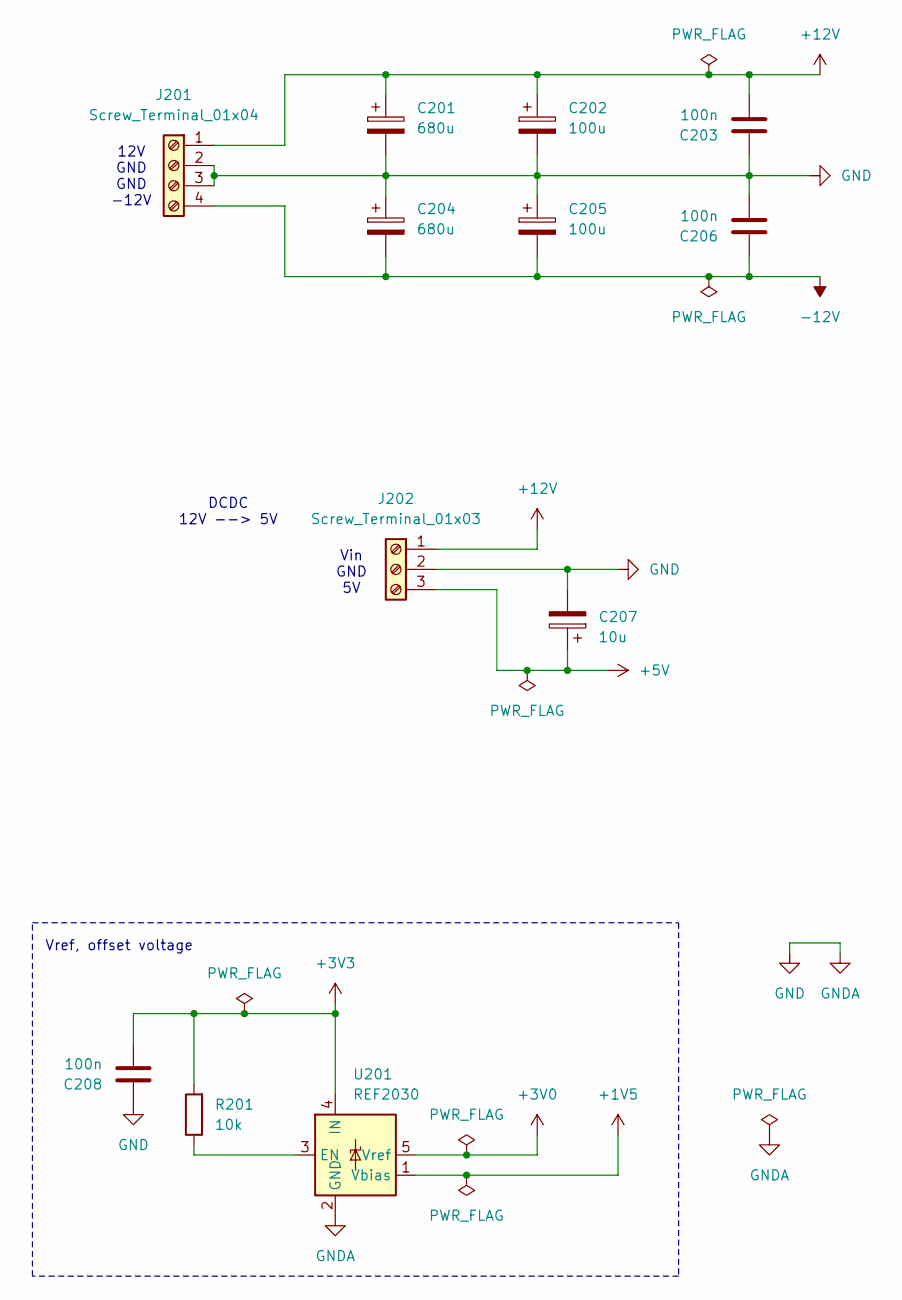
[picture p28: schematic power.kicad_sch]

Parts:
C201, C204: 680u; CP_Radial_D8.0mm_P5.00mm
C202, C205: 100u; CP_Radial_D8.0mm_P3.50mm
C203, C206, C208: 100n; C_1206_3216Metric_Pad1.33x1.80mm_HandSolder
C207: 10u; CP_Radial_D6.3mm_P2.50mm
J201: Screw_Terminal_01x04; TerminalBlock_MaiXu_MX126-5.0-04P_1x04_P5.00mm
J202: Screw_Terminal_01x03; TerminalBlock_MaiXu_MX126-5.0-03P_1x03_P5.00mm
R201: 10k; R_1206_3216Metric_Pad1.30x1.75mm_HandSolder
U201: REF2030; SOT-23-5

Connections:
+1V5: U201.1 (Vbias); also elsewhere on the board
+3V0: U201.5 (Vref); also elsewhere on the board
+3V3: C208.2, R201.2, U201.4 (IN); also elsewhere on the board
+5V: C207.1, J202.3; also elsewhere on the board
+12V: C201.1, C202.1, C203.2, J201.1, J202.1; also elsewhere on the board
-12V: C204.2, C205.2, C206.1, J201.4; also elsewhere on the board
GND: C201.2, C202.2, C203.1, C204.1, C205.1, C206.2, C207.2, C208.1, J201.2, J201.3, J202.2, U201.2 (GND); also elsewhere on the board
unnamed: R201.1, U201.3 (EN)

Notes on the sheet:
DCDC 12V --> 5V
Vin GND 5V
Vref, offset voltage
12V GND GND -12V

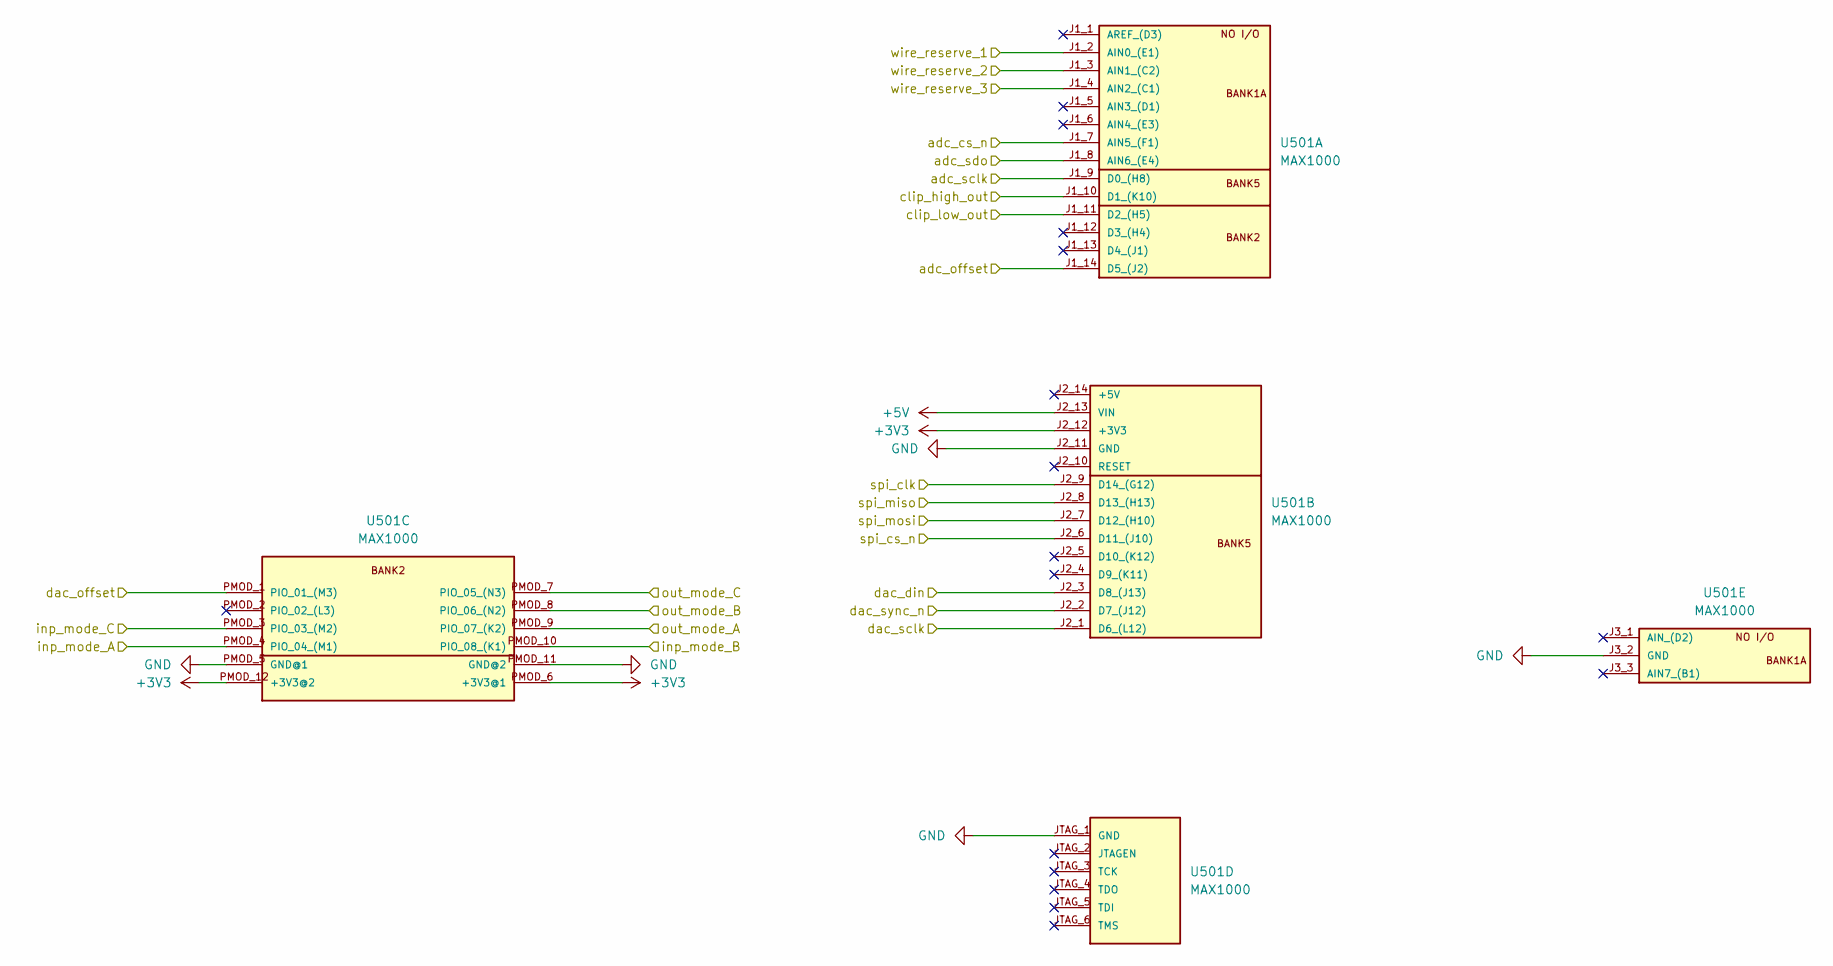
[picture p29: schematic dsv.kicad_sch]

Parts:
U501: MAX1000

Connections:
+3V3: U501.J2_12 (+3V3), U501.PMOD_6 (+3V3@1), U501.PMOD_12 (+3V3@2); also elsewhere on the board
+5V: U501.J2_13 (VIN); also elsewhere on the board
/Analog Output/dac_din: U501.J2_3 (D8_(J13)); also elsewhere on the board
/Analog Output/dac_offset: U501.PMOD_1 (PIO_01_(M3)); also elsewhere on the board
/Analog Output/dac_sclk: U501.J2_1 (D6_(L12)); also elsewhere on the board
/Analog Output/dac_sync_n: U501.J2_2 (D7_(J12)); also elsewhere on the board
/Analog Output/out_mode_A: U501.PMOD_9 (PIO_07_(K2)); also elsewhere on the board
/Analog Output/out_mode_B: U501.PMOD_8 (PIO_06_(N2)); also elsewhere on the board
/Analog Output/out_mode_C: U501.PMOD_7 (PIO_05_(N3)); also elsewhere on the board
/DSV/adc_cs_n: U501.J1_7 (AIN5_(F1)); also elsewhere on the board
/DSV/adc_offset: U501.J1_14 (D5_(J2)); also elsewhere on the board
/DSV/adc_sclk: U501.J1_9 (D0_(H8)); also elsewhere on the board
/DSV/adc_sdo: U501.J1_8 (AIN6_(E4)); also elsewhere on the board
/DSV/clip_high_out: U501.J1_10 (D1_(K10)); also elsewhere on the board
/DSV/clip_low_out: U501.J1_11 (D2_(H5)); also elsewhere on the board
/DSV/inp_mode_A: U501.PMOD_4 (PIO_04_(M1)); also elsewhere on the board
/DSV/inp_mode_B: U501.PMOD_10 (PIO_08_(K1)); also elsewhere on the board
/DSV/inp_mode_C: U501.PMOD_3 (PIO_03_(M2)); also elsewhere on the board
/DSV/spi_clk: U501.J2_9 (D14_(G12)); also elsewhere on the board
/DSV/spi_cs_n: U501.J2_6 (D11_(J10)); also elsewhere on the board
/DSV/spi_miso: U501.J2_8 (D13_(H13)); also elsewhere on the board
/DSV/spi_mosi: U501.J2_7 (D12_(H10)); also elsewhere on the board
/DSV/wire_reserve_1: U501.J1_2 (AIN0_(E1)); also elsewhere on the board
/DSV/wire_reserve_2: U501.J1_3 (AIN1_(C2)); also elsewhere on the board
/DSV/wire_reserve_3: U501.J1_4 (AIN2_(C1)); also elsewhere on the board
GND: U501.J2_11 (GND), U501.J3_2 (GND), U501.JTAG_1 (GND), U501.PMOD_5 (GND@1), U501.PMOD_11 (GND@2); also elsewhere on the board

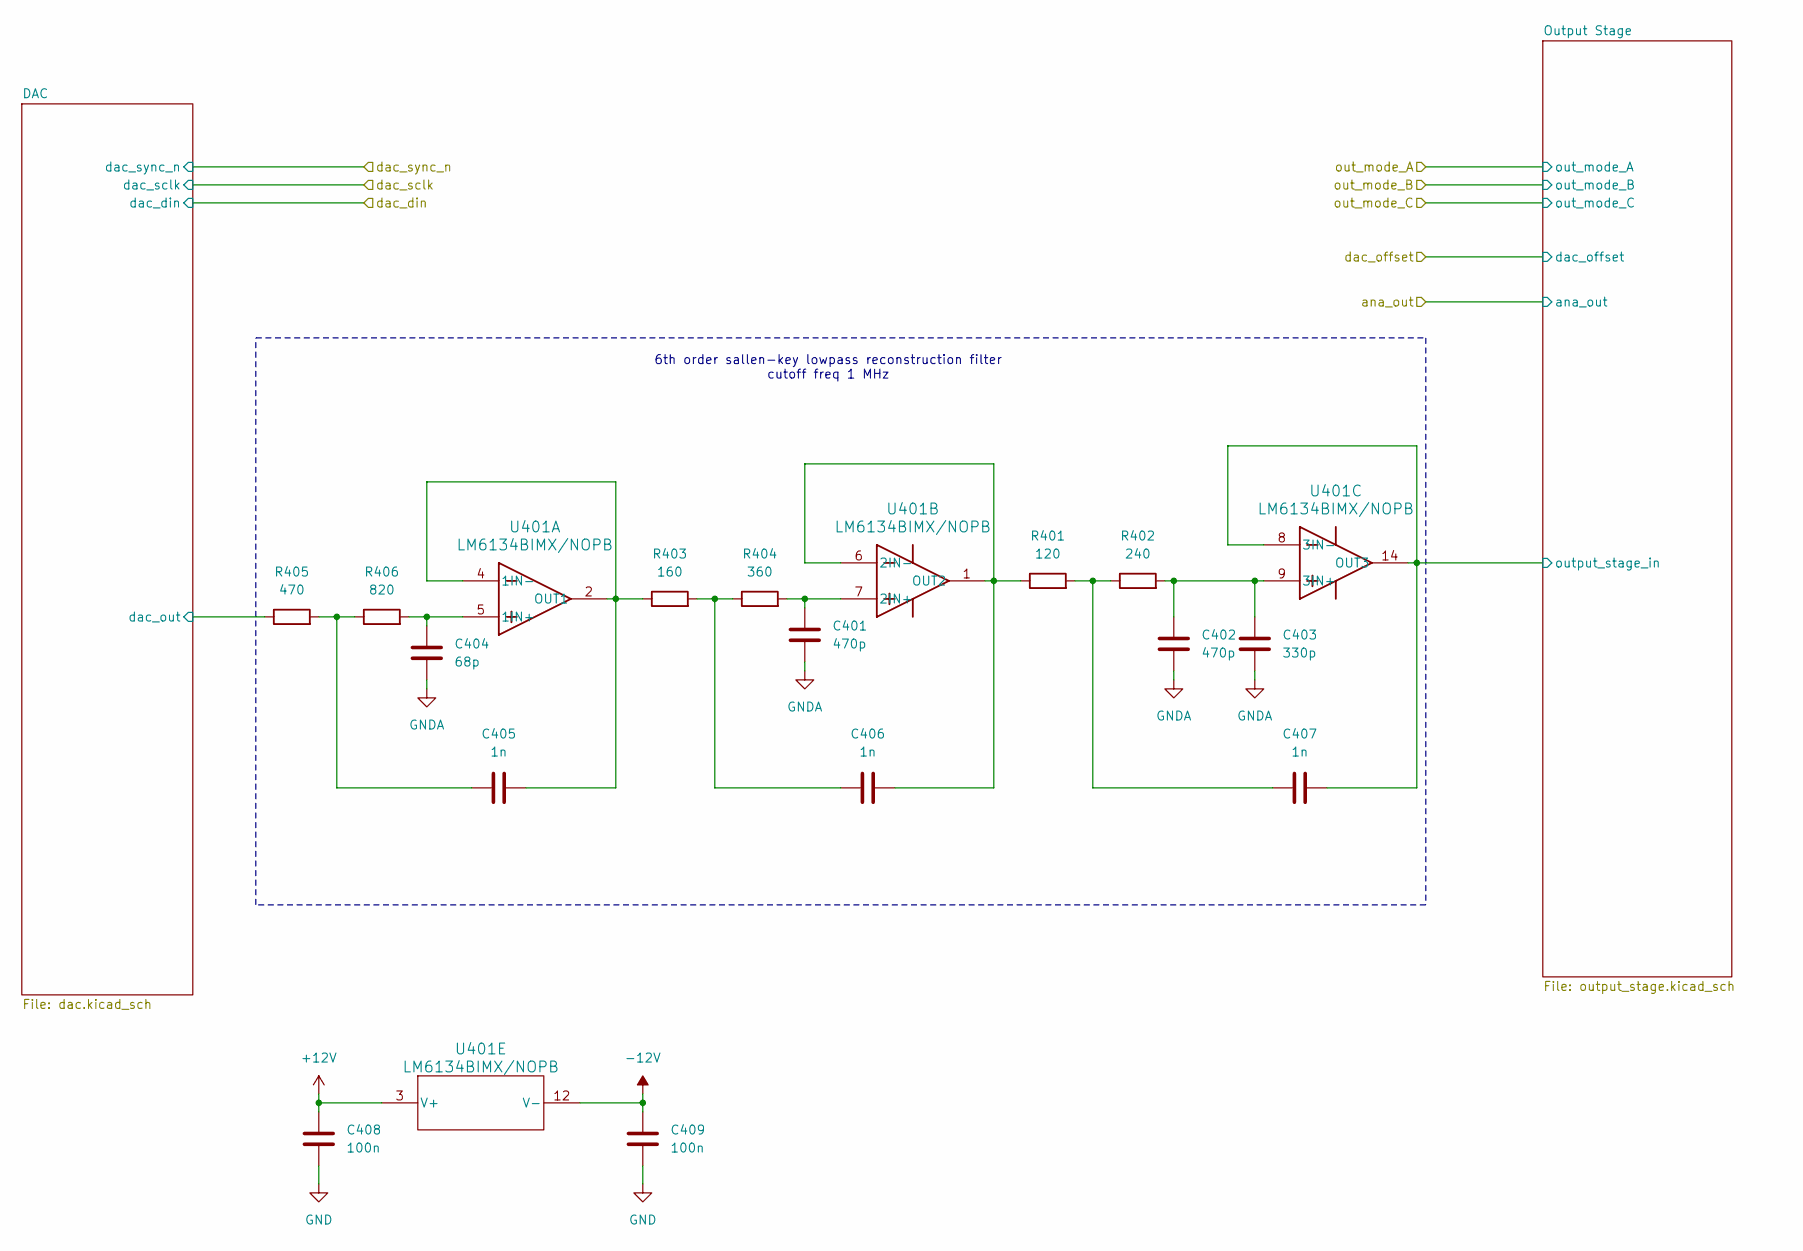
[picture p30: schematic analog_output.kicad_sch]

Parts:
C401, C402: 470p; C_0603_1608Metric_Pad1.08x0.95mm_HandSolder
C403: 330p; C_0603_1608Metric_Pad1.08x0.95mm_HandSolder
C404: 68p; C_0603_1608Metric_Pad1.08x0.95mm_HandSolder
C405, C406, C407: 1n; C_1206_3216Metric_Pad1.33x1.80mm_HandSolder
C408, C409: 100n; C_1206_3216Metric_Pad1.33x1.80mm_HandSolder
R401: 120; R_1206_3216Metric_Pad1.30x1.75mm_HandSolder
R402: 240; R_1206_3216Metric_Pad1.30x1.75mm_HandSolder
R403: 160; R_1206_3216Metric_Pad1.30x1.75mm_HandSolder
R404: 360; R_1206_3216Metric_Pad1.30x1.75mm_HandSolder
R405: 470; R_1206_3216Metric_Pad1.30x1.75mm_HandSolder
R406: 820; R_1206_3216Metric_Pad1.30x1.75mm_HandSolder
U401: LM6134BIMX/NOPB; SOIC-14_3.9x8.7mm_P1.27mm

Connections:
+12V: C408.1, U401.3 (V+); also elsewhere on the board
-12V: C409.1, U401.12 (V-); also elsewhere on the board
/Analog Output/DAC/dac_out: R405.1; also elsewhere on the board
/Analog Output/Output Stage/output_stage_in: C407.2, U401.8 (3IN-), U401.14 (OUT3); also elsewhere on the board
GND: C401.2, C402.2, C403.2, C404.2, C408.2, C409.2; also elsewhere on the board
unnamed: C405.1, R405.2, R406.1
unnamed: C406.1, R403.2, R404.1
unnamed: C407.1, R401.2, R402.1
unnamed: C404.1, R406.2, U401.5 (1IN+)
unnamed: C405.2, R403.1, U401.2 (OUT1), U401.4 (1IN-)
unnamed: C401.1, R404.2, U401.7 (2IN+)
unnamed: C406.2, R401.1, U401.1 (OUT2), U401.6 (2IN-)
unnamed: C402.1, C403.1, R402.2, U401.9 (3IN+)

Notes on the sheet:
6th order sallen-key lowpass reconstruction filter cutoff freq 1 MHz

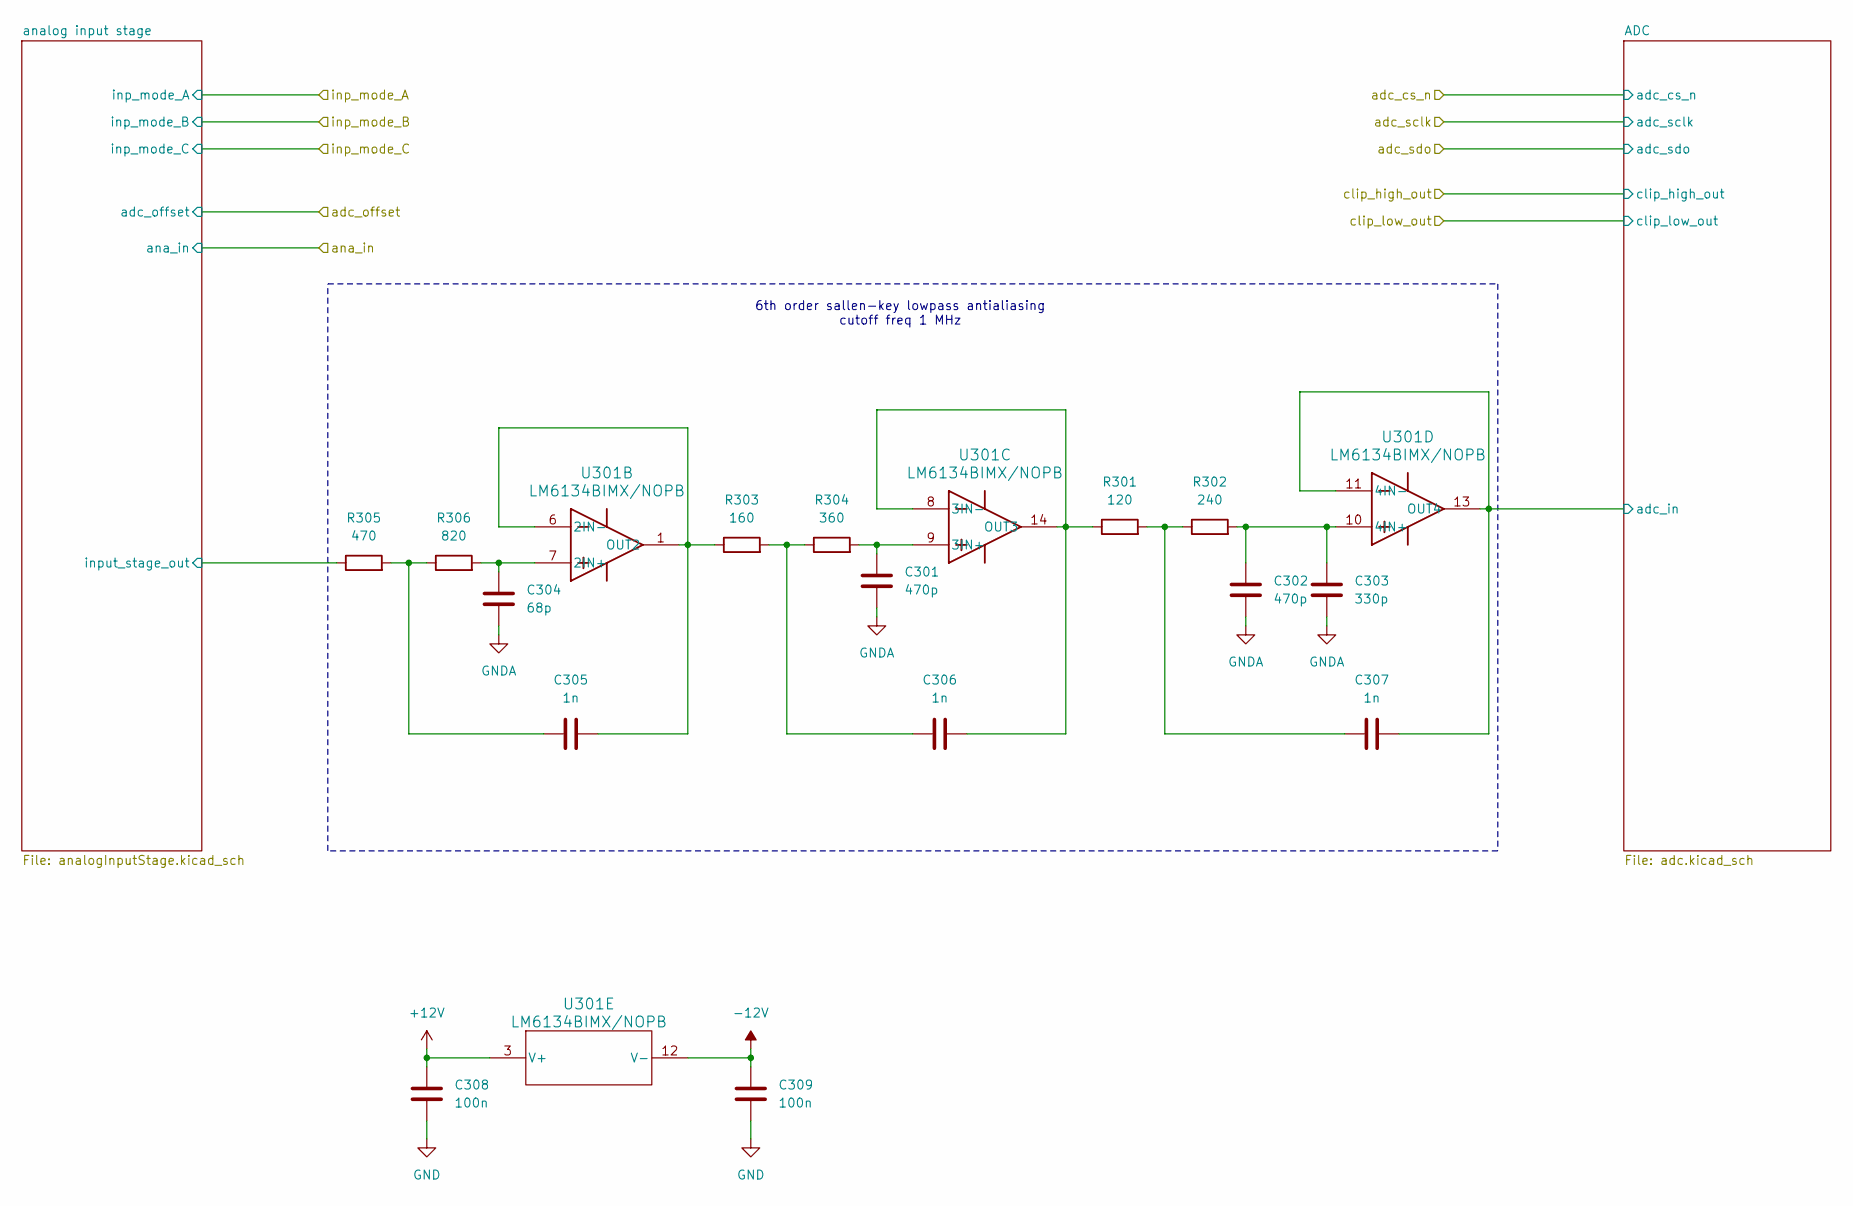
[picture p31: schematic analog_input.kicad_sch]

Parts:
C301, C302: 470p; C_0603_1608Metric_Pad1.08x0.95mm_HandSolder
C303: 330p; C_0603_1608Metric_Pad1.08x0.95mm_HandSolder
C304: 68p; C_0603_1608Metric_Pad1.08x0.95mm_HandSolder
C305, C306, C307: 1n; C_1206_3216Metric_Pad1.33x1.80mm_HandSolder
C308, C309: 100n; C_1206_3216Metric_Pad1.33x1.80mm_HandSolder
R301: 120; R_1206_3216Metric_Pad1.30x1.75mm_HandSolder
R302: 240; R_1206_3216Metric_Pad1.30x1.75mm_HandSolder
R303: 160; R_1206_3216Metric_Pad1.30x1.75mm_HandSolder
R304: 360; R_1206_3216Metric_Pad1.30x1.75mm_HandSolder
R305: 470; R_1206_3216Metric_Pad1.30x1.75mm_HandSolder
R306: 820; R_1206_3216Metric_Pad1.30x1.75mm_HandSolder
U301: LM6134BIMX/NOPB; SOIC-14_3.9x8.7mm_P1.27mm

Connections:
+12V: C308.1, U301.3 (V+); also elsewhere on the board
-12V: C309.1, U301.12 (V-); also elsewhere on the board
/analog Input/ADC/adc_in: C307.2, U301.11 (4IN-), U301.13 (OUT4); also elsewhere on the board
/analog Input/analog input stage/input_stage_out: R305.1; also elsewhere on the board
GND: C301.2, C302.2, C303.2, C304.2, C308.2, C309.2; also elsewhere on the board
unnamed: C305.1, R305.2, R306.1
unnamed: C306.1, R303.2, R304.1
unnamed: C307.1, R301.2, R302.1
unnamed: C304.1, R306.2, U301.7 (2IN+)
unnamed: C305.2, R303.1, U301.1 (OUT2), U301.6 (2IN-)
unnamed: C301.1, R304.2, U301.9 (3IN+)
unnamed: C306.2, R301.1, U301.8 (3IN-), U301.14 (OUT3)
unnamed: C302.1, C303.1, R302.2, U301.10 (4IN+)

Notes on the sheet:
6th order sallen-key lowpass antialiasing cutoff freq 1 MHz

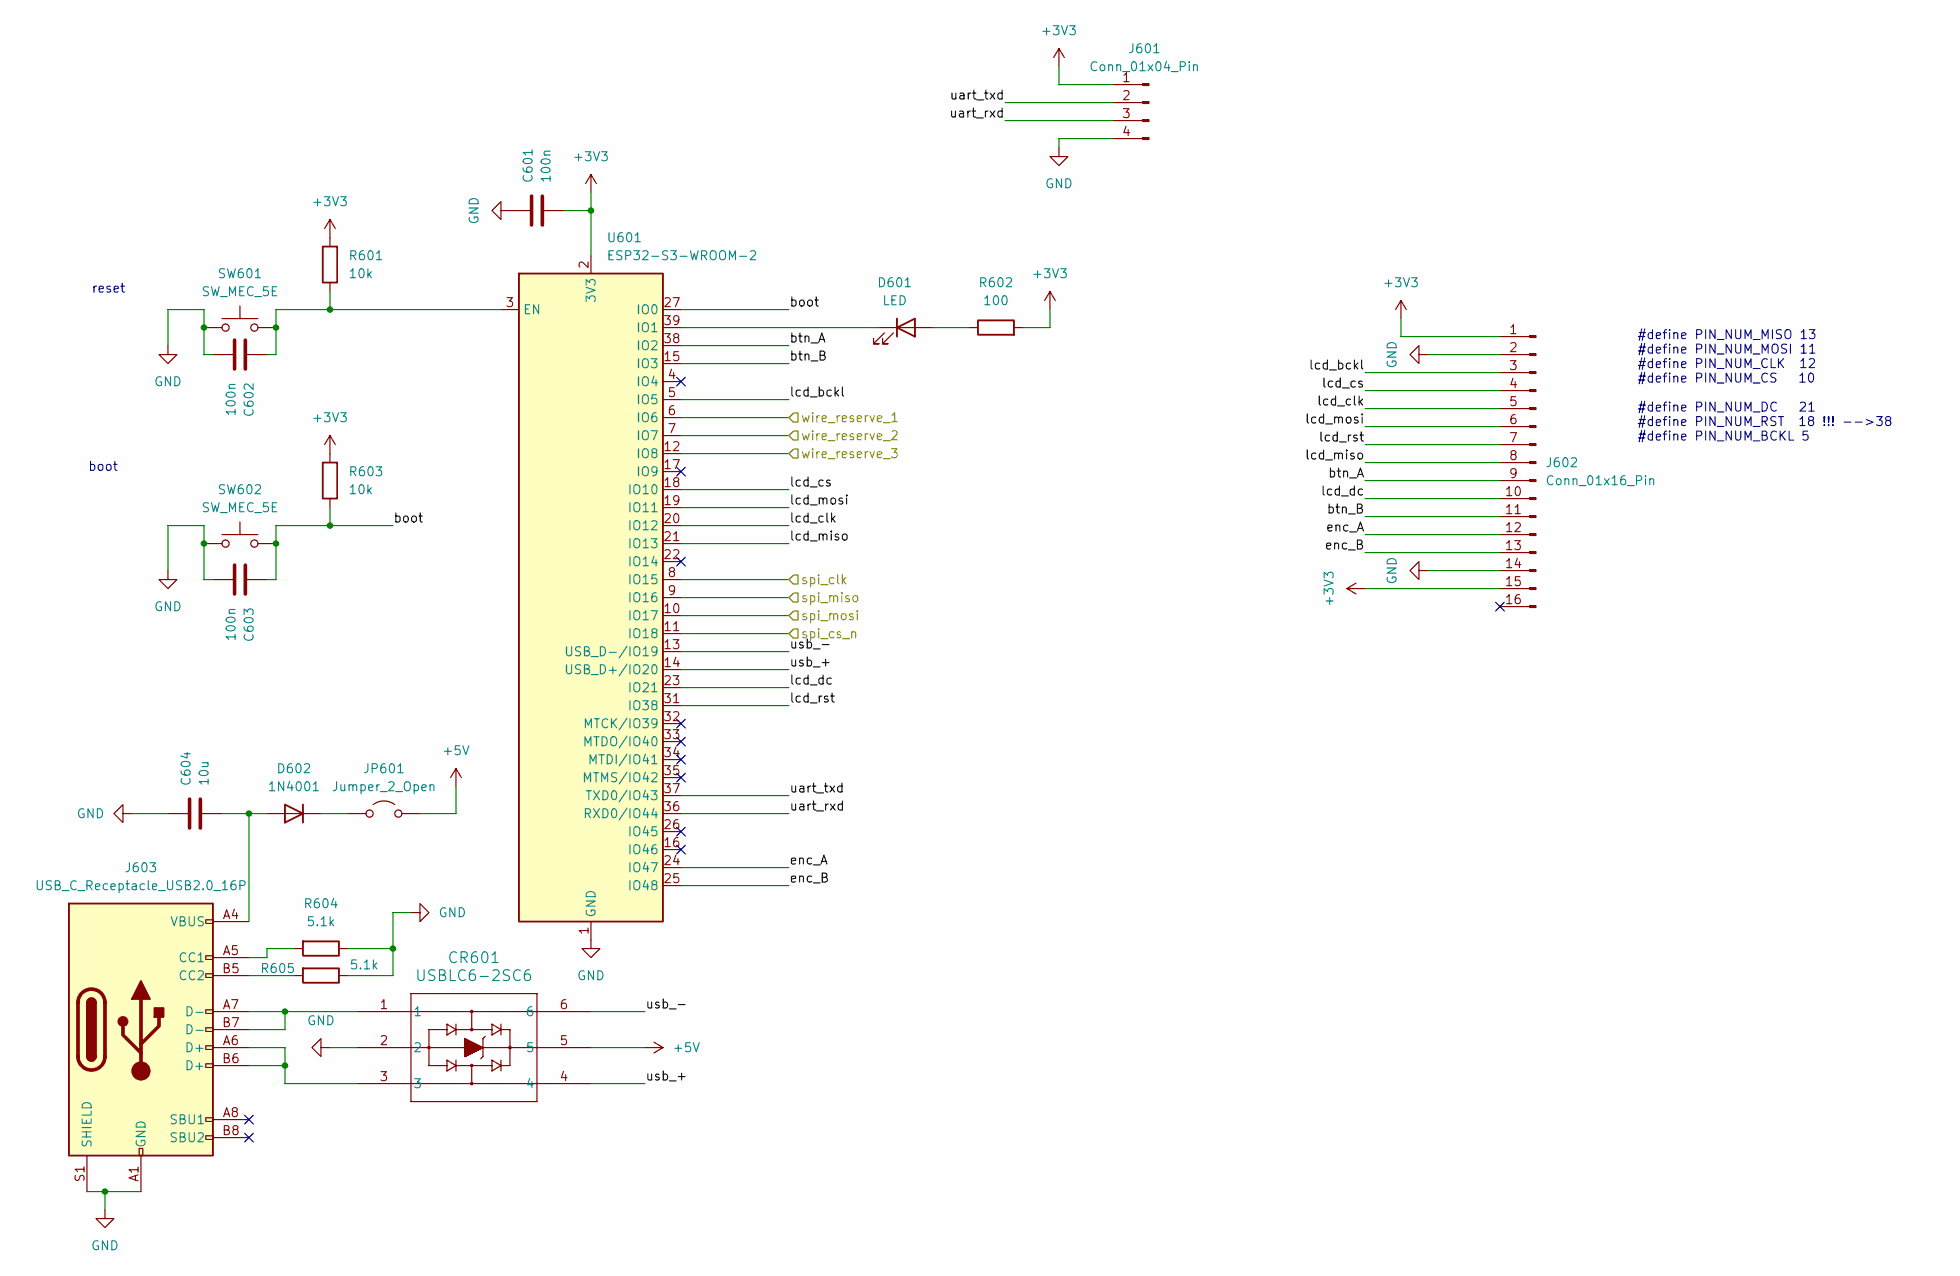
[picture p32: schematic mcu.kicad_sch]

Parts:
C601, C602, C603: 100n; C_1206_3216Metric_Pad1.33x1.80mm_HandSolder
C604: 10u; C_1206_3216Metric_Pad1.33x1.80mm_HandSolder
CR601: USBLC6-2SC6; SOT-23-6_Handsoldering
D601: LED; LED_1206_3216Metric_Pad1.42x1.75mm_HandSolder
D602: 1N4001; D_DO-41_SOD81_P10.16mm_Horizontal
J601: Conn_01x04_Pin; PinHeader_1x04_P2.54mm_Vertical
J602: Conn_01x16_Pin; PinHeader_2x08_P2.54mm_Vertical
J603: USB_C_Receptacle_USB2.0_16P; USB_C_Receptacle_GCT_USB4105-xx-A_16P_TopMnt_Horizontal
JP601: Jumper_2_Open; PinHeader_1x02_P2.54mm_Vertical
R601, R603: 10k; R_1206_3216Metric_Pad1.30x1.75mm_HandSolder
R602: 100; R_1206_3216Metric_Pad1.30x1.75mm_HandSolder
R604, R605: 5.1k; R_1206_3216Metric_Pad1.30x1.75mm_HandSolder
SW601, SW602: SW_MEC_5E; SW_Push_1P1T_NO_CK_KSC9xxJ
U601: ESP32-S3-WROOM-2

Connections:
+3V3: C601.2, J601.1, J602.1, J602.15, R601.2, R602.2, R603.2, U601.2 (3V3); also elsewhere on the board
+5V: CR601.5, JP601.2 (B); also elsewhere on the board
/DSV/spi_clk: U601.8 (IO15); also elsewhere on the board
/DSV/spi_cs_n: U601.11 (IO18); also elsewhere on the board
/DSV/spi_miso: U601.9 (IO16); also elsewhere on the board
/DSV/spi_mosi: U601.10 (IO17); also elsewhere on the board
/DSV/wire_reserve_1: U601.6 (IO6); also elsewhere on the board
/DSV/wire_reserve_2: U601.7 (IO7); also elsewhere on the board
/DSV/wire_reserve_3: U601.12 (IO8); also elsewhere on the board
/MCU/boot: C603.1, R603.1, SW602.2, U601.27 (IO0)
/MCU/btn_A: J602.9, U601.38 (IO2)
/MCU/btn_B: J602.11, U601.15 (IO3)
/MCU/enc_A: J602.12, U601.24 (IO47)
/MCU/enc_B: J602.13, U601.25 (IO48)
/MCU/lcd_bckl: J602.3, U601.5 (IO5)
/MCU/lcd_clk: J602.5, U601.20 (IO12)
/MCU/lcd_cs: J602.4, U601.18 (IO10)
/MCU/lcd_dc: J602.10, U601.23 (IO21)
/MCU/lcd_miso: J602.8, U601.21 (IO13)
/MCU/lcd_mosi: J602.6, U601.19 (IO11)
/MCU/lcd_rst: J602.7, U601.31 (IO38)
/MCU/uart_rxd: J601.3, U601.36 (RXD0/IO44)
/MCU/uart_txd: J601.2, U601.37 (TXD0/IO43)
/MCU/usb_+: CR601.4, U601.14 (USB_D+/IO20)
/MCU/usb_-: CR601.6, U601.13 (USB_D-/IO19)
GND: C601.1, C602.2, C603.2, C604.1, CR601.2, J601.4, J602.2, J602.14, J603.A1 (GND), J603.A12 (GND), J603.B1 (GND), J603.B12 (GND), J603.S1 (SHIELD), R604.1, R605.1, SW601.1, SW602.1, U601.1 (GND), U601.40 (GND), U601.41 (GND); also elsewhere on the board
unnamed: CR601.1, J603.A7 (D-), J603.B7 (D-)
unnamed: CR601.3, J603.A6 (D+), J603.B6 (D+)
unnamed: D601.2 (A), R602.1
unnamed: D601.1 (K), U601.39 (IO1)
unnamed: C604.2, D602.2 (A), J603.A4 (VBUS), J603.A9 (VBUS), J603.B4 (VBUS), J603.B9 (VBUS)
unnamed: D602.1 (K), JP601.1 (A)
unnamed: J603.A5 (CC1), R604.2
unnamed: J603.B5 (CC2), R605.2
unnamed: C602.1, R601.1, SW601.2, U601.3 (EN)

Notes on the sheet:
boot
reset
#define PIN_NUM_MISO 13 #define PIN_NUM_MOSI 11 #define PIN_NUM_CLK 12 #define PIN_NUM_CS 10 #define PIN_NUM_DC 21 #define PIN_NUM_RST 18 !!! -->38 #define PIN_NUM_BCKL 5
