SimonKohler88/esl1_fpga_fir/hw/kicad/v1/v1.kicad_pcb

## KiCad design hw/kicad/v1/v1.kicad_pcb (continued)

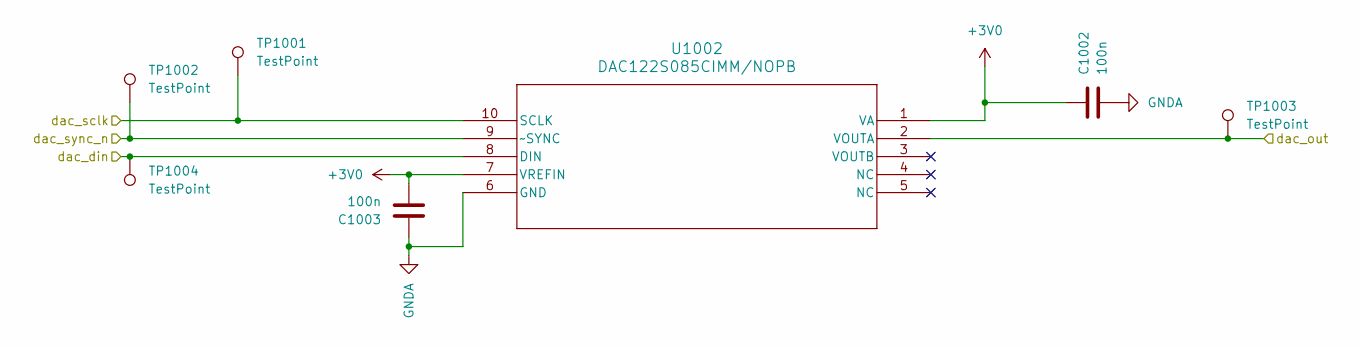
[picture p33: schematic dac.kicad_sch]

Parts:
C1002, C1003: 100n; C_1206_3216Metric_Pad1.33x1.80mm_HandSolder
TP1001, TP1002, TP1003, TP1004: TestPoint; TestPoint_Pad_D1.0mm
U1002: DAC122S085CIMM/NOPB; VSSOP-10_3x3mm_P0.5mm

Connections:
+3V0: C1002.1, C1003.2, U1002.1 (VA), U1002.7 (VREFIN); also elsewhere on the board
/Analog Output/DAC/dac_out: TP1003.1, U1002.2 (VOUTA); also elsewhere on the board
/Analog Output/dac_din: TP1004.1, U1002.8 (DIN); also elsewhere on the board
/Analog Output/dac_sclk: TP1001.1, U1002.10 (SCLK); also elsewhere on the board
/Analog Output/dac_sync_n: TP1002.1, U1002.9 (~SYNC); also elsewhere on the board
GND: C1002.2, C1003.1, U1002.6 (GND); also elsewhere on the board

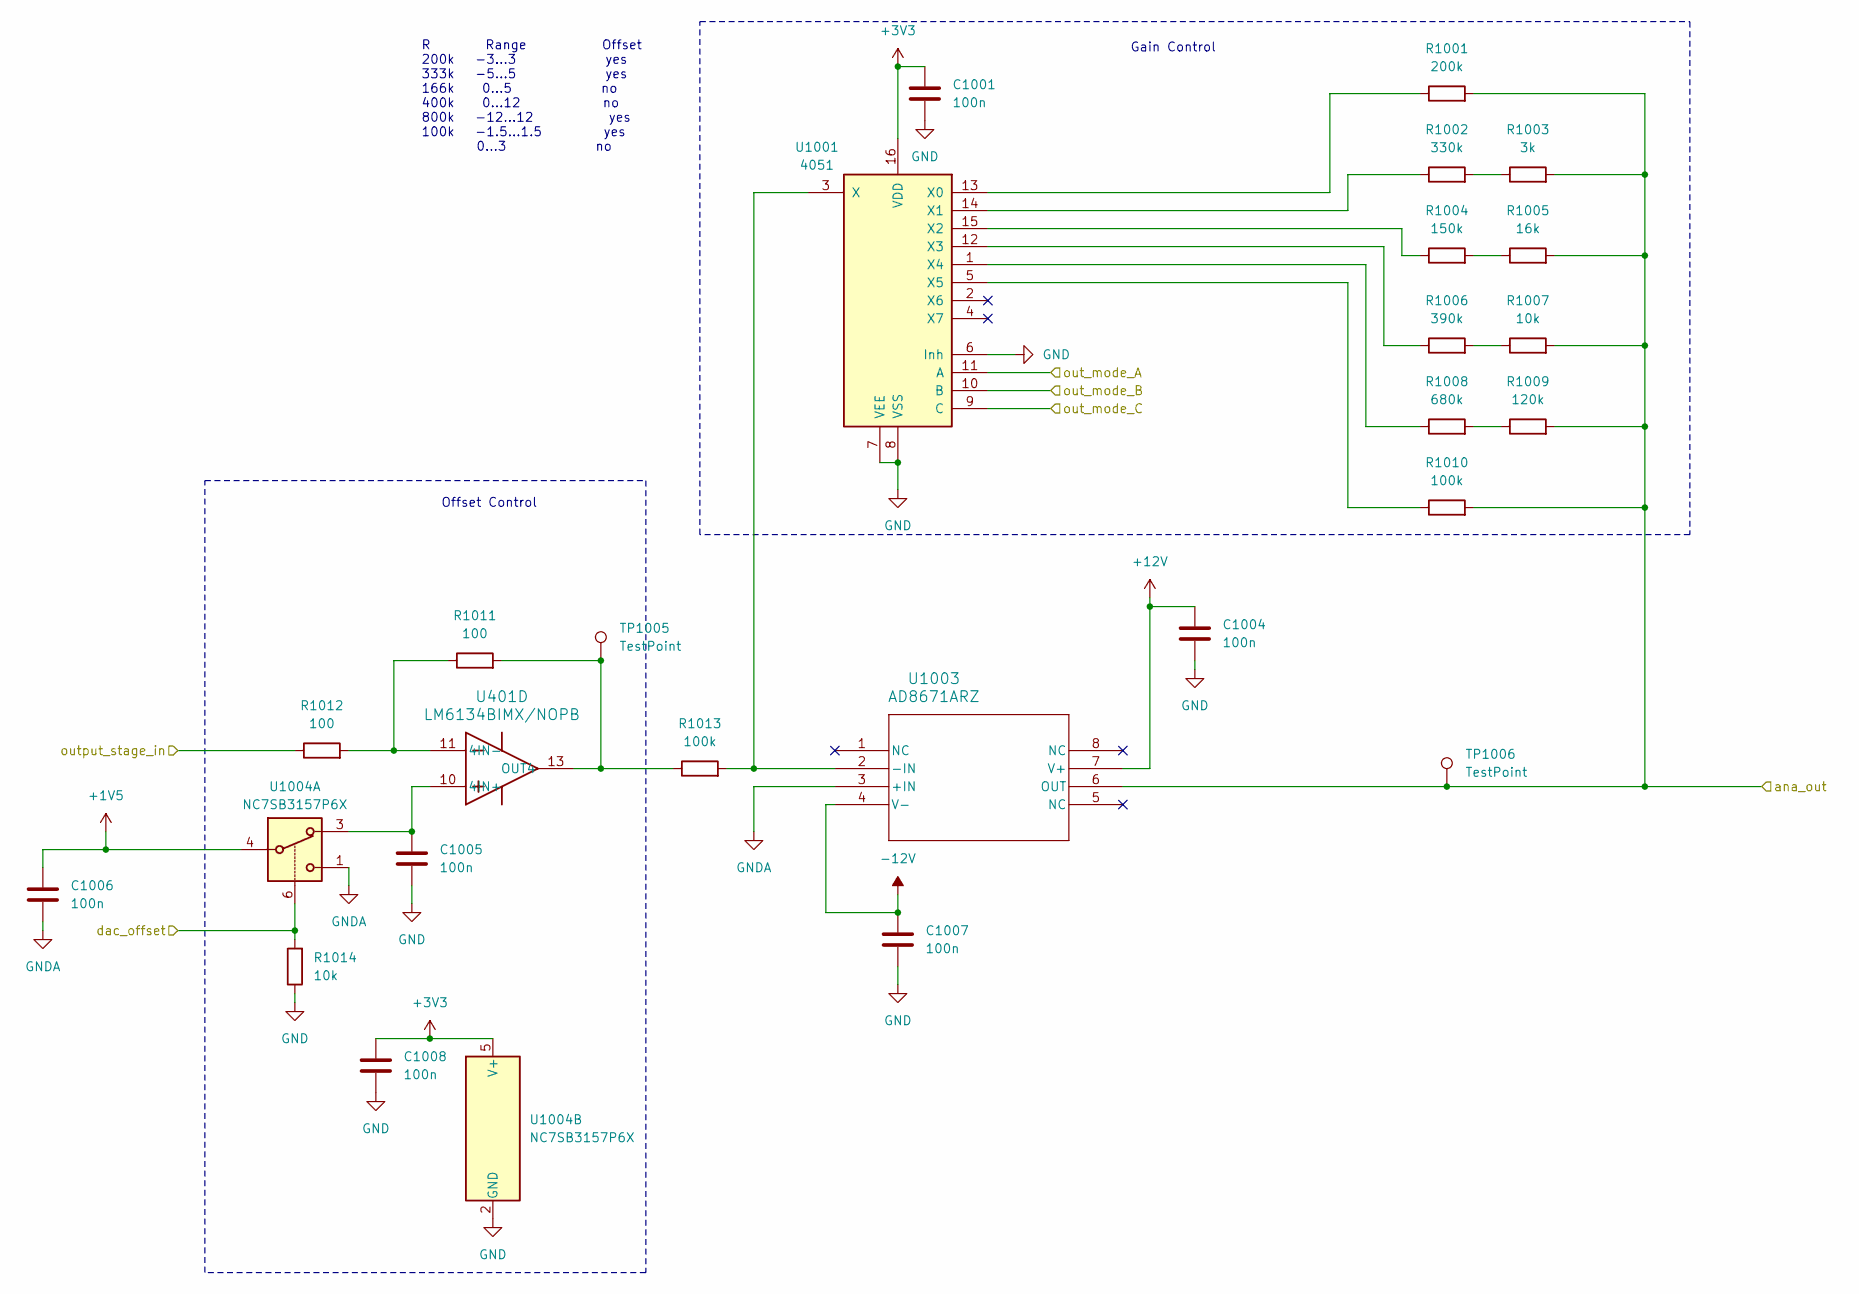
[picture p34: schematic output_stage.kicad_sch]

Parts:
C1001, C1004, C1005, C1007, C1008: 100n; C_1206_3216Metric_Pad1.33x1.80mm_HandSolder
C1006: 100n; C_0603_1608Metric_Pad1.08x0.95mm_HandSolder
R1001: 200k; R_1206_3216Metric_Pad1.30x1.75mm_HandSolder
R1002: 330k; R_1206_3216Metric_Pad1.30x1.75mm_HandSolder
R1003: 3k; R_1206_3216Metric_Pad1.30x1.75mm_HandSolder
R1004: 150k; R_1206_3216Metric_Pad1.30x1.75mm_HandSolder
R1005: 16k; R_1206_3216Metric_Pad1.30x1.75mm_HandSolder
R1006: 390k; R_1206_3216Metric_Pad1.30x1.75mm_HandSolder
R1007, R1014: 10k; R_1206_3216Metric_Pad1.30x1.75mm_HandSolder
R1008: 680k; R_1206_3216Metric_Pad1.30x1.75mm_HandSolder
R1009: 120k; R_1206_3216Metric_Pad1.30x1.75mm_HandSolder
R1010, R1013: 100k; R_1206_3216Metric_Pad1.30x1.75mm_HandSolder
R1011, R1012: 100; R_1206_3216Metric_Pad1.30x1.75mm_HandSolder
TP1005, TP1006: TestPoint; TestPoint_Pad_D1.0mm
U401: LM6134BIMX/NOPB; SOIC-14_3.9x8.7mm_P1.27mm
U1001: 4051; SOIC-16_3.9x9.9mm_P1.27mm
U1003: AD8671ARZ; R_8_ADI
U1004: NC7SB3157P6X; SOT-363_SC-70-6

Connections:
+1V5: C1006.1, U1004.4; also elsewhere on the board
+3V3: C1001.1, C1008.1, U1001.16 (VDD), U1004.5 (V+); also elsewhere on the board
+12V: C1004.1, U1003.7 (V+); also elsewhere on the board
-12V: C1007.1, U1003.4 (V-); also elsewhere on the board
/Analog Output/Output Stage/output_stage_in: R1012.1; also elsewhere on the board
/Analog Output/ana_out: R1001.2, R1003.2, R1005.2, R1007.2, R1009.2, R1010.2, TP1006.1, U1003.6 (OUT); also elsewhere on the board
/Analog Output/dac_offset: R1014.2, U1004.6; also elsewhere on the board
/Analog Output/out_mode_A: U1001.11 (A); also elsewhere on the board
/Analog Output/out_mode_B: U1001.10 (B); also elsewhere on the board
/Analog Output/out_mode_C: U1001.9 (C); also elsewhere on the board
GND: C1001.2, C1004.2, C1005.2, C1006.2, C1007.2, C1008.2, R1014.1, U1001.6 (Inh), U1001.7 (VEE), U1001.8 (VSS), U1003.3 (+IN), U1004.1, U1004.2 (GND); also elsewhere on the board
unnamed: R1002.2, R1003.1
unnamed: R1004.2, R1005.1
unnamed: R1006.2, R1007.1
unnamed: R1008.2, R1009.1
unnamed: C1005.1, U401.10 (4IN+), U1004.3
unnamed: R1011.1, R1012.2, U401.11 (4IN-)
unnamed: R1011.2, R1013.1, TP1005.1, U401.13 (OUT4)
unnamed: R1001.1, U1001.13 (X0)
unnamed: R1002.1, U1001.14 (X1)
unnamed: R1004.1, U1001.15 (X2)
unnamed: R1006.1, U1001.12 (X3)
unnamed: R1008.1, U1001.1 (X4)
unnamed: R1010.1, U1001.5 (X5)
unnamed: R1013.2, U1001.3 (X), U1003.2 (-IN)

Notes on the sheet:
R Range Offset 200k -3...3 yes 333k -5...5 yes 166k 0...5 no 400k 0...12 no 800k -12...12 yes 100k -1.5...1.5 yes 0...3 no
Offset Control
Gain Control

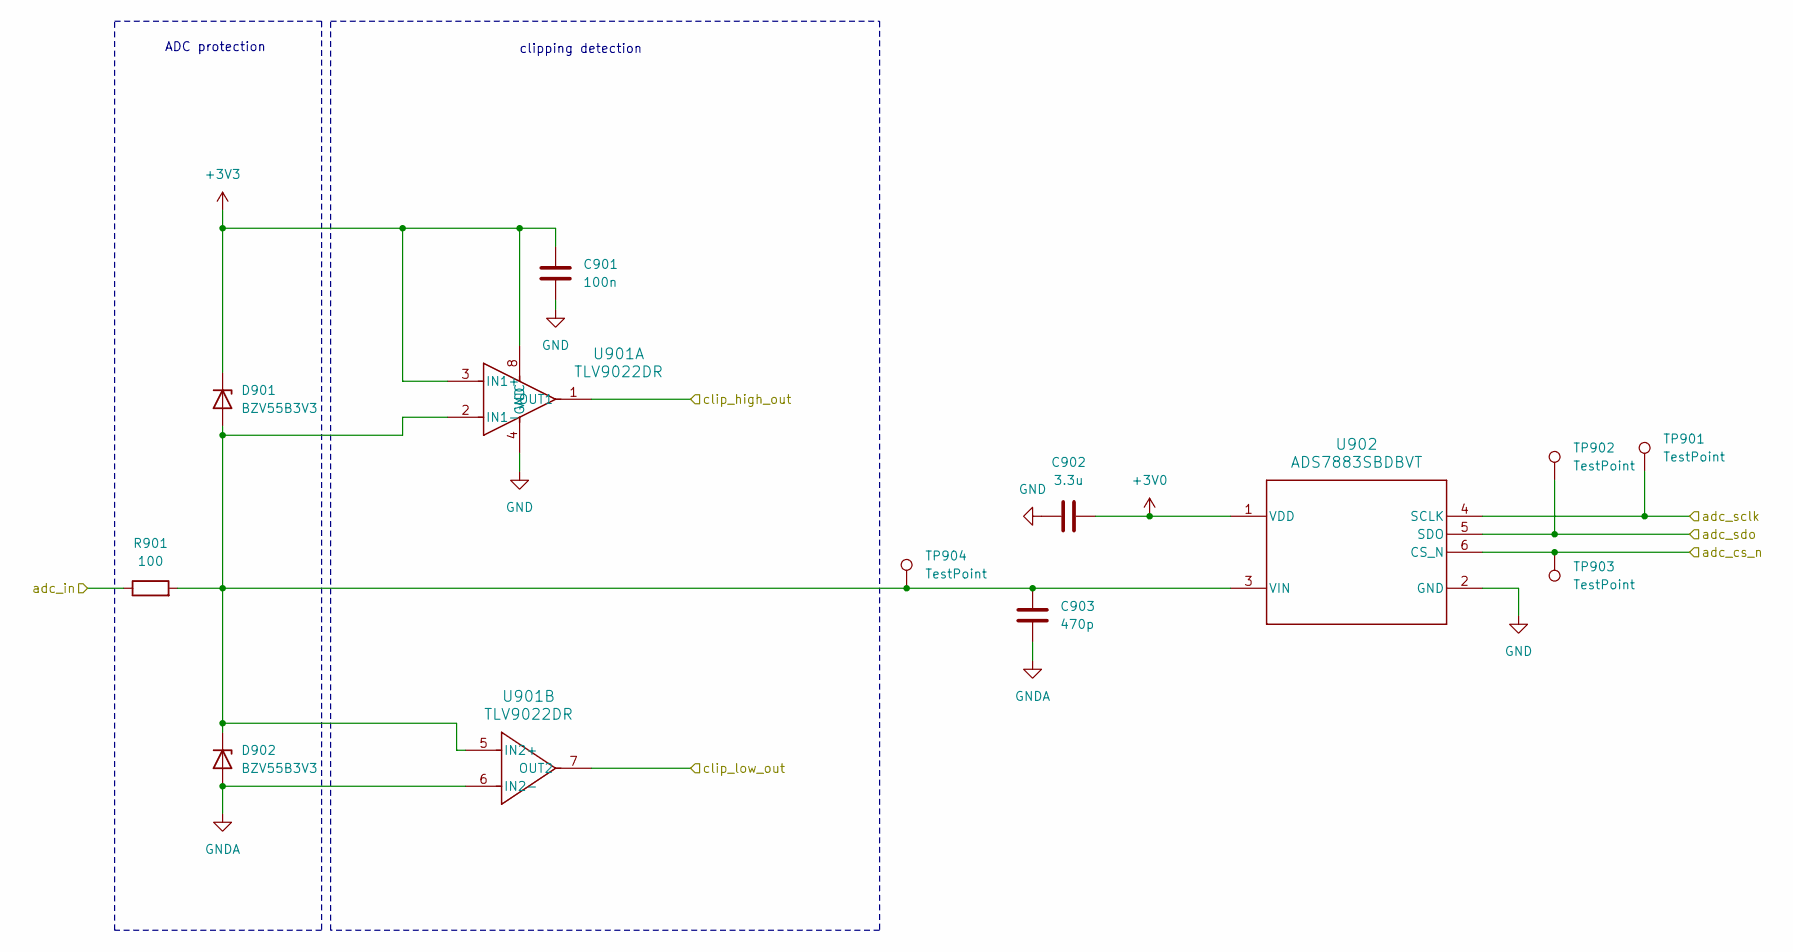
[picture p35: schematic adc.kicad_sch]

Parts:
C901: 100n; C_1206_3216Metric_Pad1.33x1.80mm_HandSolder
C902: 3.3u; C_1206_3216Metric_Pad1.33x1.80mm_HandSolder
C903: 470p; C_0603_1608Metric_Pad1.08x0.95mm_HandSolder
D901, D902: BZV55B3V3; D_MiniMELF
R901: 100; R_1206_3216Metric_Pad1.30x1.75mm_HandSolder
TP901, TP902, TP903, TP904: TestPoint; TestPoint_Pad_D1.0mm
U901: TLV9022DR; SOIC-8_3.9x4.9mm_P1.27mm
U902: ADS7883SBDBVT; SOT-23-6_Handsoldering

Connections:
+3V0: C902.2, U902.1 (VDD); also elsewhere on the board
+3V3: C901.1, D901.1 (K), U901.3 (IN1+), U901.8 (VCC); also elsewhere on the board
/DSV/adc_cs_n: TP903.1, U902.6 (CS_N); also elsewhere on the board
/DSV/adc_sclk: TP901.1, U902.4 (SCLK); also elsewhere on the board
/DSV/adc_sdo: TP902.1, U902.5 (SDO); also elsewhere on the board
/DSV/clip_high_out: U901.1 (OUT1); also elsewhere on the board
/DSV/clip_low_out: U901.7 (OUT2); also elsewhere on the board
/analog Input/ADC/adc_in: R901.1; also elsewhere on the board
GND: C901.2, C902.1, C903.2, D902.2 (A), U901.4 (GND), U901.6 (IN2-), U902.2 (GND); also elsewhere on the board
unnamed: C903.1, D901.2 (A), D902.1 (K), R901.2, TP904.1, U901.2 (IN1-), U901.5 (IN2+), U902.3 (VIN)

Notes on the sheet:
ADC protection
clipping detection

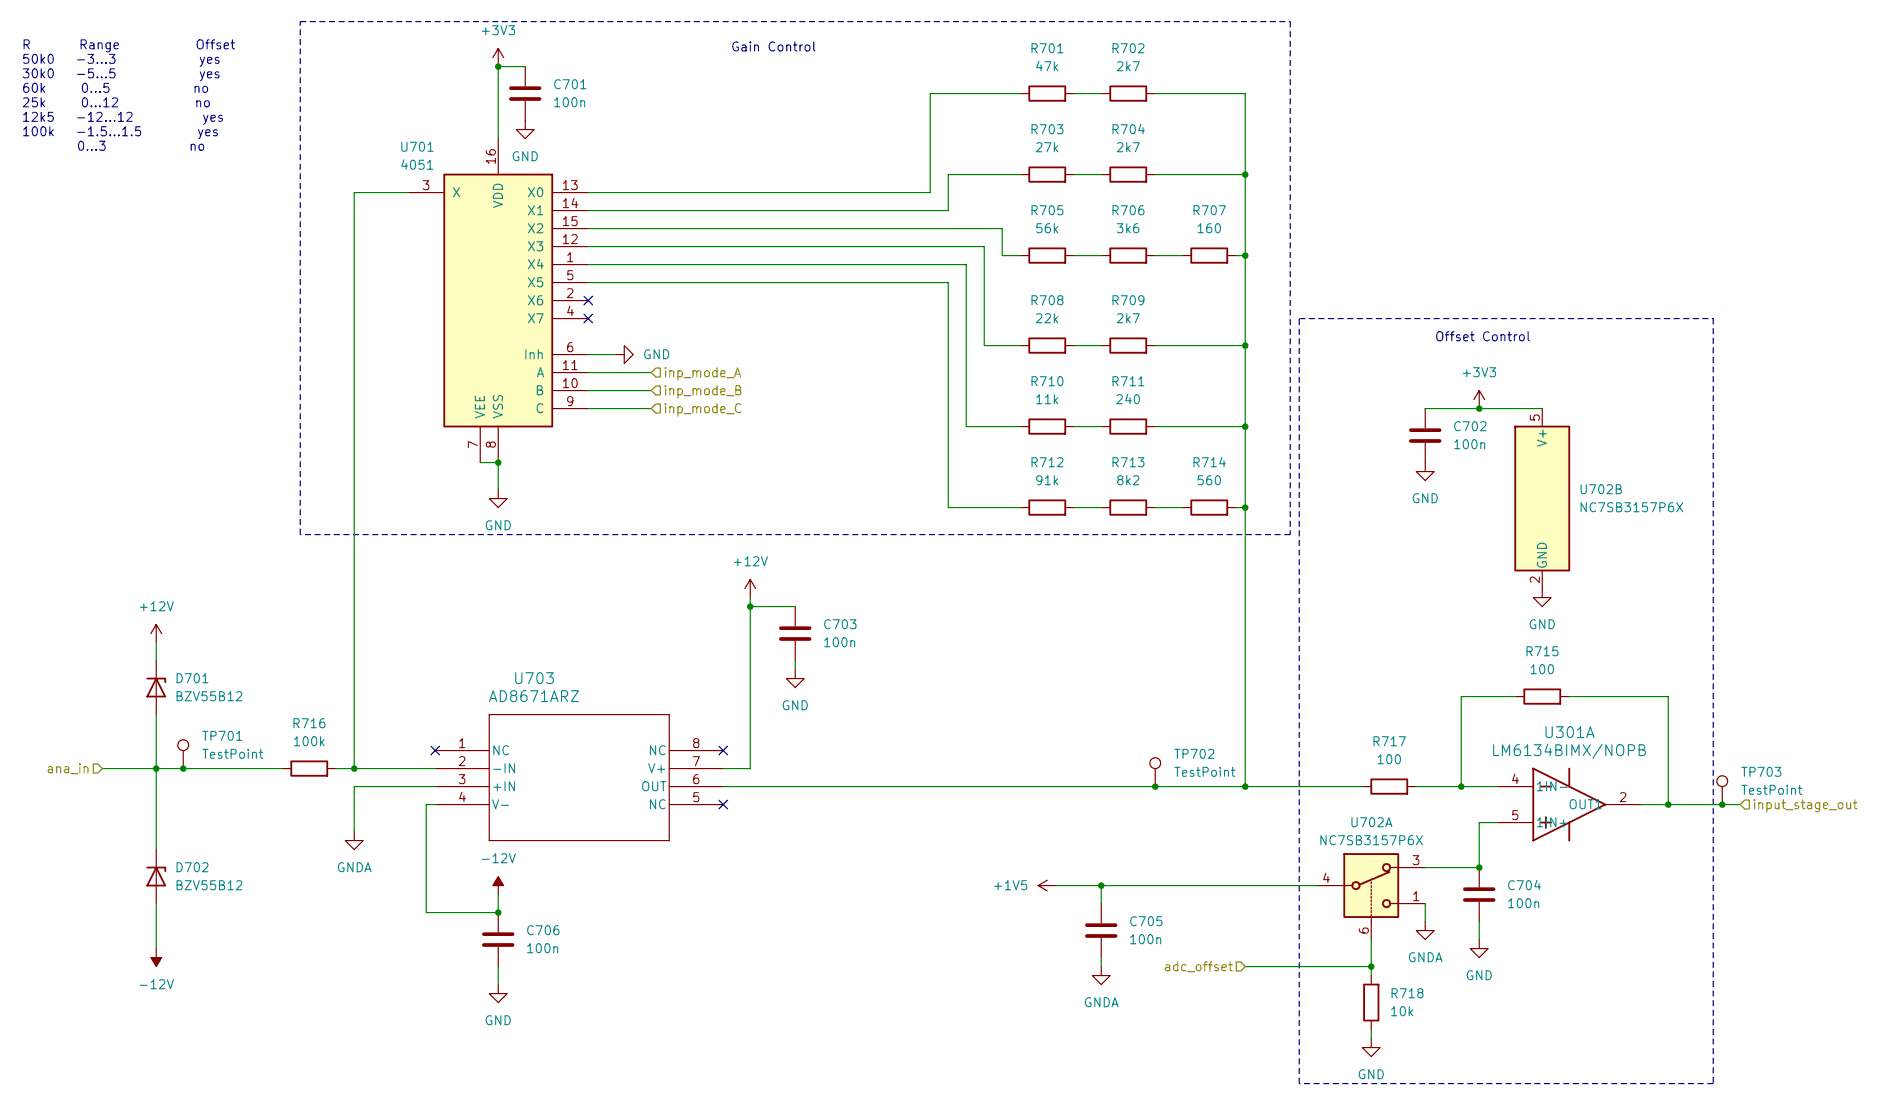
[picture p36: schematic analogInputStage.kicad_sch]

Parts:
C701, C702, C703, C704, C706: 100n; C_1206_3216Metric_Pad1.33x1.80mm_HandSolder
C705: 100n; C_0603_1608Metric_Pad1.08x0.95mm_HandSolder
D701, D702: BZV55B12; D_MiniMELF
R701: 47k; R_1206_3216Metric_Pad1.30x1.75mm_HandSolder
R702, R704, R709: 2k7; R_1206_3216Metric_Pad1.30x1.75mm_HandSolder
R703: 27k; R_1206_3216Metric_Pad1.30x1.75mm_HandSolder
R705: 56k; R_1206_3216Metric_Pad1.30x1.75mm_HandSolder
R706: 3k6; R_1206_3216Metric_Pad1.30x1.75mm_HandSolder
R707: 160; R_1206_3216Metric_Pad1.30x1.75mm_HandSolder
R708: 22k; R_1206_3216Metric_Pad1.30x1.75mm_HandSolder
R710: 11k; R_1206_3216Metric_Pad1.30x1.75mm_HandSolder
R711: 240; R_1206_3216Metric_Pad1.30x1.75mm_HandSolder
R712: 91k; R_1206_3216Metric_Pad1.30x1.75mm_HandSolder
R713: 8k2; R_1206_3216Metric_Pad1.30x1.75mm_HandSolder
R714: 560; R_1206_3216Metric_Pad1.30x1.75mm_HandSolder
R715, R717: 100; R_1206_3216Metric_Pad1.30x1.75mm_HandSolder
R716: 100k; R_1206_3216Metric_Pad1.30x1.75mm_HandSolder
R718: 10k; R_1206_3216Metric_Pad1.30x1.75mm_HandSolder
TP701, TP702, TP703: TestPoint; TestPoint_Pad_D1.0mm
U301: LM6134BIMX/NOPB; SOIC-14_3.9x8.7mm_P1.27mm
U701: 4051; SOIC-16_3.9x9.9mm_P1.27mm
U702: NC7SB3157P6X; SOT-363_SC-70-6
U703: AD8671ARZ; R_8_ADI

Connections:
+1V5: C705.1, U702.4; also elsewhere on the board
+3V3: C701.1, C702.1, U701.16 (VDD), U702.5 (V+); also elsewhere on the board
+12V: C703.1, D701.1 (K), U703.7 (V+); also elsewhere on the board
-12V: C706.1, D702.2 (A), U703.4 (V-); also elsewhere on the board
/DSV/adc_offset: R718.2, U702.6; also elsewhere on the board
/DSV/inp_mode_A: U701.11 (A); also elsewhere on the board
/DSV/inp_mode_B: U701.10 (B); also elsewhere on the board
/DSV/inp_mode_C: U701.9 (C); also elsewhere on the board
/analog Input/ana_in: D701.2 (A), D702.1 (K), R716.1, TP701.1; also elsewhere on the board
/analog Input/analog input stage/input_stage_out: R715.2, TP703.1, U301.2 (OUT1); also elsewhere on the board
GND: C701.2, C702.2, C703.2, C704.2, C705.2, C706.2, R718.1, U701.6 (Inh), U701.7 (VEE), U701.8 (VSS), U702.1, U702.2 (GND), U703.3 (+IN); also elsewhere on the board
unnamed: R701.2, R702.1
unnamed: R703.2, R704.1
unnamed: R705.2, R706.1
unnamed: R706.2, R707.1
unnamed: R708.2, R709.1
unnamed: R710.2, R711.1
unnamed: R712.2, R713.1
unnamed: R713.2, R714.1
unnamed: C704.1, U301.5 (1IN+), U702.3
unnamed: R715.1, R717.2, U301.4 (1IN-)
unnamed: R701.1, U701.13 (X0)
unnamed: R703.1, U701.14 (X1)
unnamed: R705.1, U701.15 (X2)
unnamed: R708.1, U701.12 (X3)
unnamed: R710.1, U701.1 (X4)
unnamed: R712.1, U701.5 (X5)
unnamed: R716.2, U701.3 (X), U703.2 (-IN)
unnamed: R702.2, R704.2, R707.2, R709.2, R711.2, R714.2, R717.1, TP702.1, U703.6 (OUT)

Notes on the sheet:
R Range Offset 50k0 -3...3 yes 30k0 -5...5 yes 60k 0...5 no 25k 0...12 no 12k5 -12...12 yes 100k -1.5...1.5 yes 0...3 no
Gain Control
Offset Control

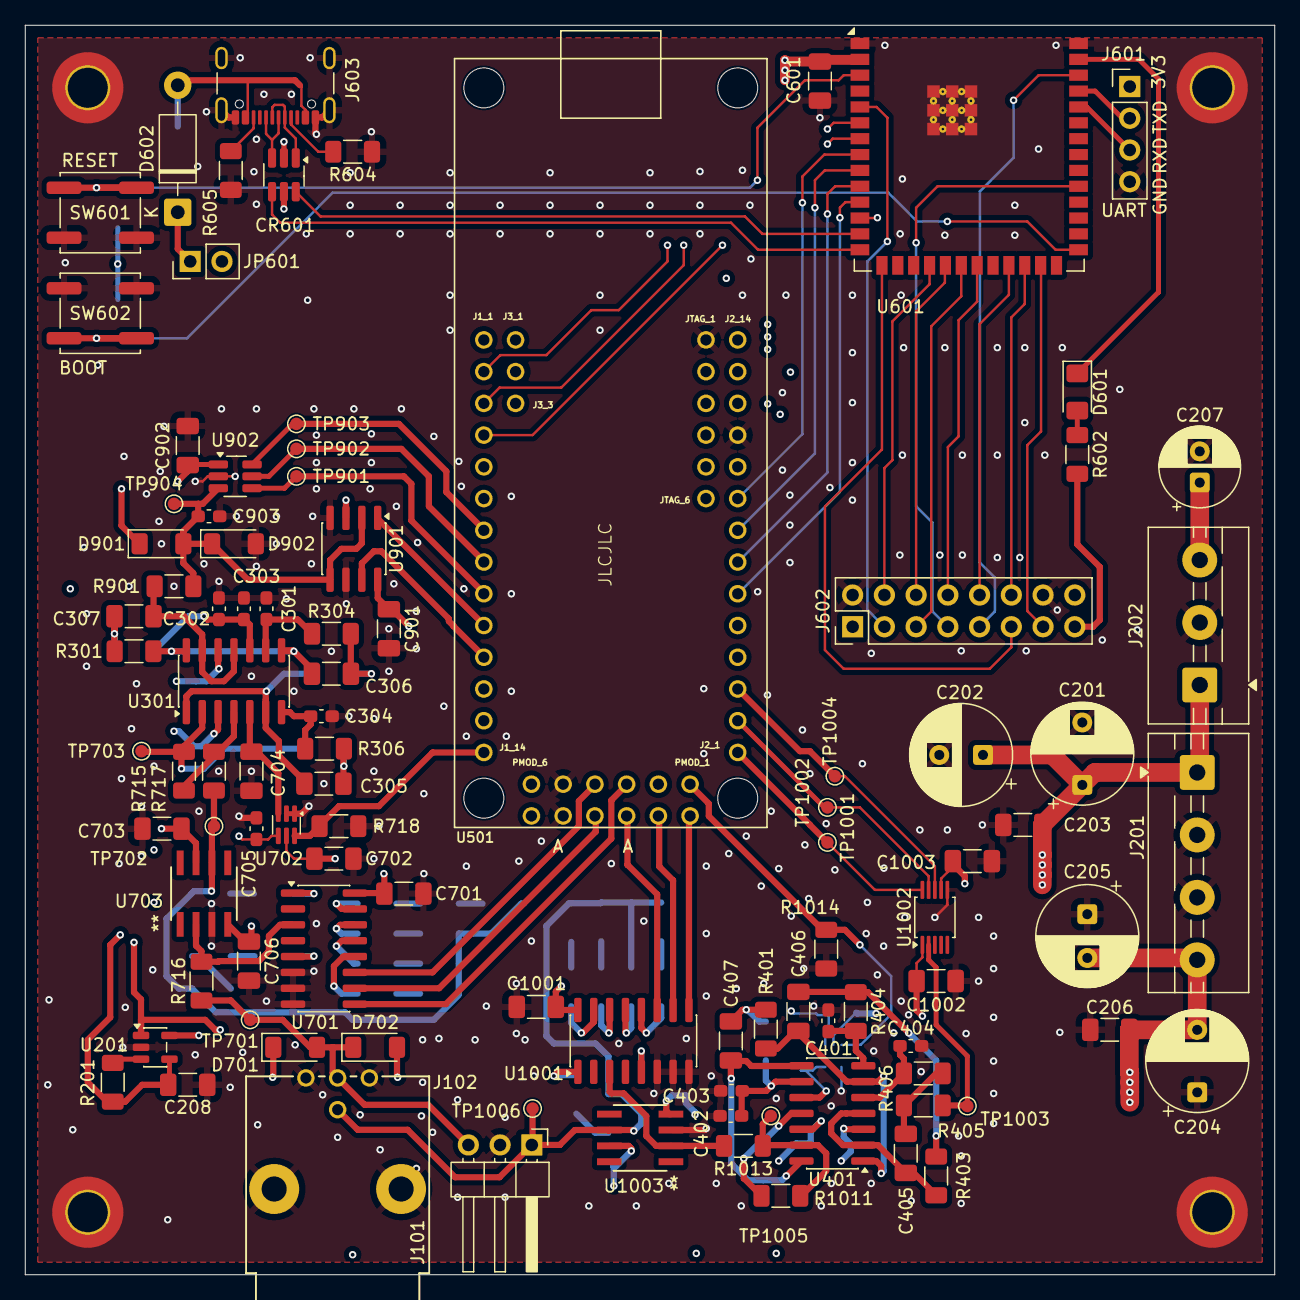
[picture p37: board v1.kicad_pcb from above]

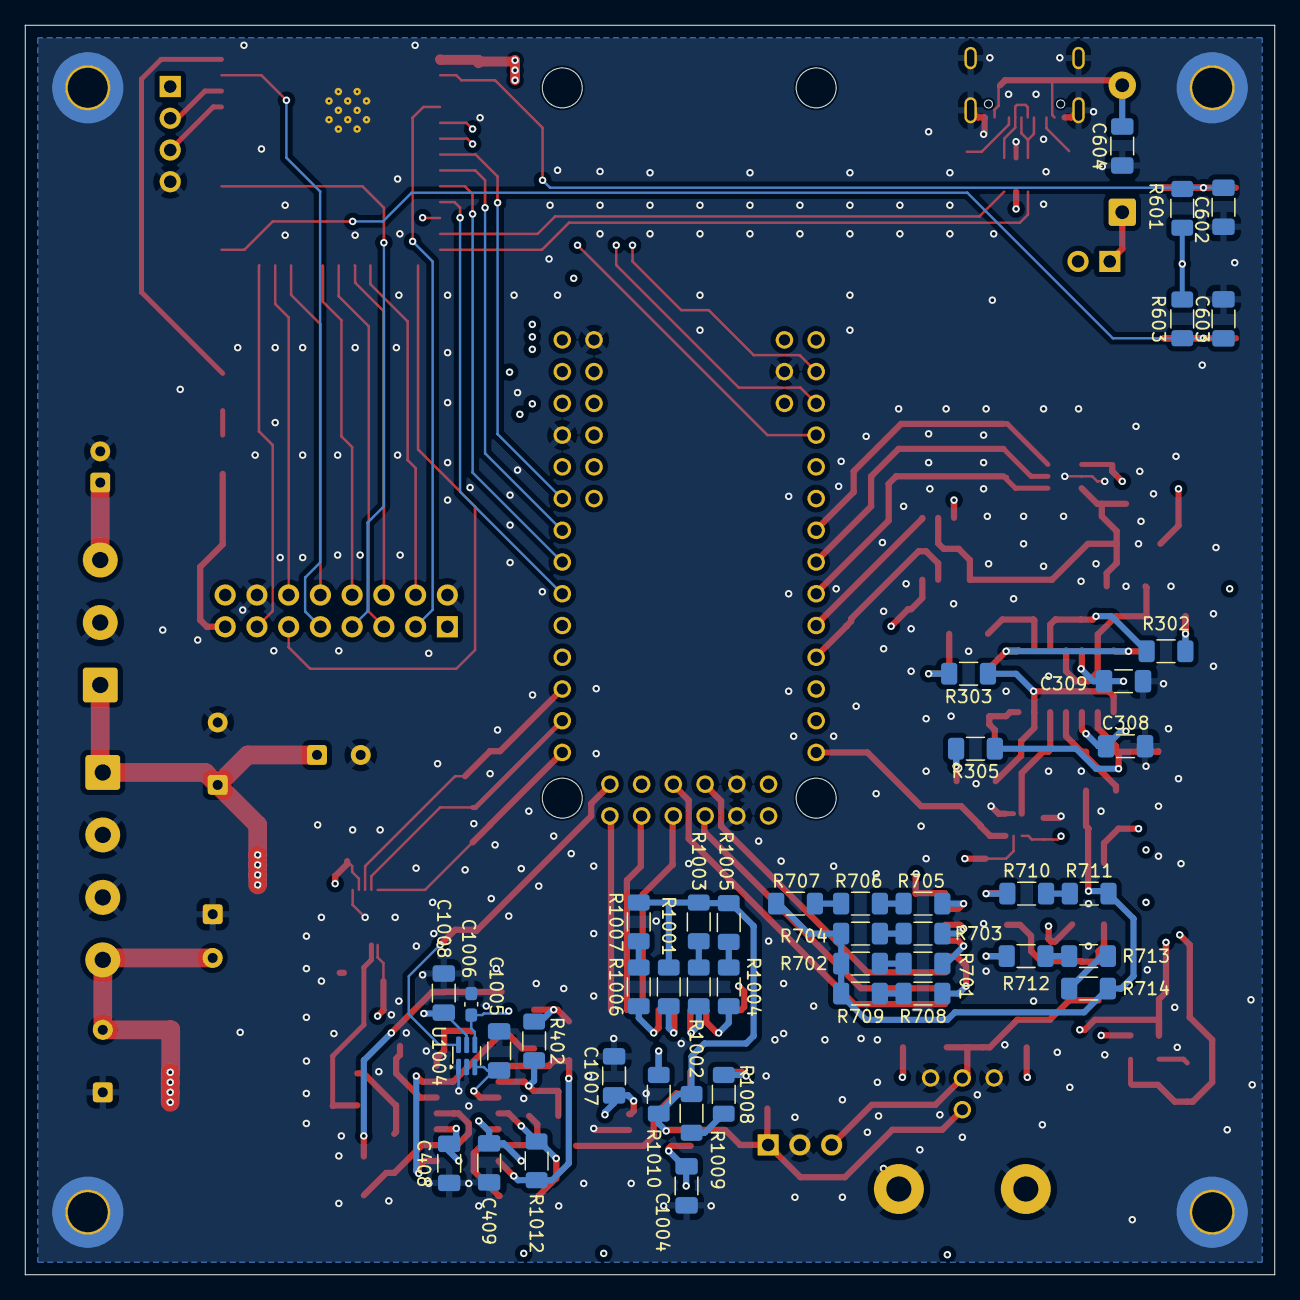
[picture p38: board v1.kicad_pcb from below]

Board: 4 copper layers, 100.0 x 100.0 mm, 146 parts (44 on the bottom side), 111 nets.
