SimonKohler88/esl1_fpga_fir/quartus_proj/uart_nios_qsys/software/fir_uart_nios_bsp/system.h

/*
 * system.h - SOPC Builder system and BSP software package information
 *
 * Machine generated for CPU 'nios2_gen2_0' in SOPC Builder design 'uart_nios'
 * SOPC Builder design path: ../../uart_nios.sopcinfo
 *
 * Generated: Tue Nov 11 13:47:27 CET 2025
 */

/*
 * DO NOT MODIFY THIS FILE
 *
 * Changing this file will have subtle consequences
 * which will almost certainly lead to a nonfunctioning
 * system. If you do modify this file, be aware that your
 * changes will be overwritten and lost when this file
 * is generated again.
 *
 * DO NOT MODIFY THIS FILE
 */

/*
 * License Agreement
 *
 * Copyright (c) 2008
 * Altera Corporation, San Jose, California, USA.
 * All rights reserved.
 *
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
 * This agreement shall be governed in all respects by the laws of the State
 * of California and by the laws of the United States of America.
 */

#ifndef __SYSTEM_H_
#define __SYSTEM_H_

/* Include definitions from linker script generator */
#include "linker.h"


/*
 * CPU configuration
 *
 */

#define ALT_CPU_ARCHITECTURE "altera_nios2_gen2"
#define ALT_CPU_BIG_ENDIAN 0
#define ALT_CPU_BREAK_ADDR 0x00040820
#define ALT_CPU_CPU_ARCH_NIOS2_R1
#define ALT_CPU_CPU_FREQ 120000000u
#define ALT_CPU_CPU_ID_SIZE 1
#define ALT_CPU_CPU_ID_VALUE 0x00000000
#define ALT_CPU_CPU_IMPLEMENTATION "fast"
#define ALT_CPU_DATA_ADDR_WIDTH 0x13
#define ALT_CPU_DCACHE_BYPASS_MASK 0x80000000
#define ALT_CPU_DCACHE_LINE_SIZE 32
#define ALT_CPU_DCACHE_LINE_SIZE_LOG2 5
#define ALT_CPU_DCACHE_SIZE 2048
#define ALT_CPU_EXCEPTION_ADDR 0x00020020
#define ALT_CPU_FLASH_ACCELERATOR_LINES 0
#define ALT_CPU_FLASH_ACCELERATOR_LINE_SIZE 0
#define ALT_CPU_FLUSHDA_SUPPORTED
#define ALT_CPU_FREQ 120000000
#define ALT_CPU_HARDWARE_DIVIDE_PRESENT 0
#define ALT_CPU_HARDWARE_MULTIPLY_PRESENT 1
#define ALT_CPU_HARDWARE_MULX_PRESENT 0
#define ALT_CPU_HAS_DEBUG_CORE 1
#define ALT_CPU_HAS_DEBUG_STUB
#define ALT_CPU_HAS_EXTRA_EXCEPTION_INFO
#define ALT_CPU_HAS_ILLEGAL_INSTRUCTION_EXCEPTION
#define ALT_CPU_HAS_JMPI_INSTRUCTION
#define ALT_CPU_ICACHE_LINE_SIZE 32
#define ALT_CPU_ICACHE_LINE_SIZE_LOG2 5
#define ALT_CPU_ICACHE_SIZE 4096
#define ALT_CPU_INITDA_SUPPORTED
#define ALT_CPU_INST_ADDR_WIDTH 0x13
#define ALT_CPU_NAME "nios2_gen2_0"
#define ALT_CPU_NUM_OF_SHADOW_REG_SETS 0
#define ALT_CPU_OCI_VERSION 1
#define ALT_CPU_RESET_ADDR 0x00020000


/*
 * CPU configuration (with legacy prefix - don't use these anymore)
 *
 */

#define NIOS2_BIG_ENDIAN 0
#define NIOS2_BREAK_ADDR 0x00040820
#define NIOS2_CPU_ARCH_NIOS2_R1
#define NIOS2_CPU_FREQ 120000000u
#define NIOS2_CPU_ID_SIZE 1
#define NIOS2_CPU_ID_VALUE 0x00000000
#define NIOS2_CPU_IMPLEMENTATION "fast"
#define NIOS2_DATA_ADDR_WIDTH 0x13
#define NIOS2_DCACHE_BYPASS_MASK 0x80000000
#define NIOS2_DCACHE_LINE_SIZE 32
#define NIOS2_DCACHE_LINE_SIZE_LOG2 5
#define NIOS2_DCACHE_SIZE 2048
#define NIOS2_EXCEPTION_ADDR 0x00020020
#define NIOS2_FLASH_ACCELERATOR_LINES 0
#define NIOS2_FLASH_ACCELERATOR_LINE_SIZE 0
#define NIOS2_FLUSHDA_SUPPORTED
#define NIOS2_HARDWARE_DIVIDE_PRESENT 0
#define NIOS2_HARDWARE_MULTIPLY_PRESENT 1
#define NIOS2_HARDWARE_MULX_PRESENT 0
#define NIOS2_HAS_DEBUG_CORE 1
#define NIOS2_HAS_DEBUG_STUB
#define NIOS2_HAS_EXTRA_EXCEPTION_INFO
#define NIOS2_HAS_ILLEGAL_INSTRUCTION_EXCEPTION
#define NIOS2_HAS_JMPI_INSTRUCTION
#define NIOS2_ICACHE_LINE_SIZE 32
#define NIOS2_ICACHE_LINE_SIZE_LOG2 5
#define NIOS2_ICACHE_SIZE 4096
#define NIOS2_INITDA_SUPPORTED
#define NIOS2_INST_ADDR_WIDTH 0x13
#define NIOS2_NUM_OF_SHADOW_REG_SETS 0
#define NIOS2_OCI_VERSION 1
#define NIOS2_RESET_ADDR 0x00020000


/*
 * Define for each module class mastered by the CPU
 *
 */

#define __ALTERA_AVALON_JTAG_UART
#define __ALTERA_AVALON_MM_BRIDGE
#define __ALTERA_AVALON_ONCHIP_MEMORY2
#define __ALTERA_AVALON_PIO
#define __ALTERA_AVALON_TIMER
#define __ALTERA_AVALON_UART
#define __ALTERA_NIOS2_GEN2


/*
 * System configuration
 *
 */

#define ALT_DEVICE_FAMILY "Cyclone V"
#define ALT_ENHANCED_INTERRUPT_API_PRESENT
#define ALT_IRQ_BASE NULL
#define ALT_LOG_PORT "/dev/null"
#define ALT_LOG_PORT_BASE 0x0
#define ALT_LOG_PORT_DEV null
#define ALT_LOG_PORT_TYPE ""
#define ALT_NUM_EXTERNAL_INTERRUPT_CONTROLLERS 0
#define ALT_NUM_INTERNAL_INTERRUPT_CONTROLLERS 1
#define ALT_NUM_INTERRUPT_CONTROLLERS 1
#define ALT_STDERR "/dev/jtag_uart_0"
#define ALT_STDERR_BASE 0x41450
#define ALT_STDERR_DEV jtag_uart_0
#define ALT_STDERR_IS_JTAG_UART
#define ALT_STDERR_PRESENT
#define ALT_STDERR_TYPE "altera_avalon_jtag_uart"
#define ALT_STDIN "/dev/jtag_uart_0"
#define ALT_STDIN_BASE 0x41450
#define ALT_STDIN_DEV jtag_uart_0
#define ALT_STDIN_IS_JTAG_UART
#define ALT_STDIN_PRESENT
#define ALT_STDIN_TYPE "altera_avalon_jtag_uart"
#define ALT_STDOUT "/dev/jtag_uart_0"
#define ALT_STDOUT_BASE 0x41450
#define ALT_STDOUT_DEV jtag_uart_0
#define ALT_STDOUT_IS_JTAG_UART
#define ALT_STDOUT_PRESENT
#define ALT_STDOUT_TYPE "altera_avalon_jtag_uart"
#define ALT_SYSTEM_NAME "uart_nios"


/*
 * hal configuration
 *
 */

#define ALT_INCLUDE_INSTRUCTION_RELATED_EXCEPTION_API
#define ALT_MAX_FD 32
#define ALT_SYS_CLK none
#define ALT_TIMESTAMP_CLK none


/*
 * jtag_uart_0 configuration
 *
 */

#define ALT_MODULE_CLASS_jtag_uart_0 altera_avalon_jtag_uart
#define JTAG_UART_0_BASE 0x41450
#define JTAG_UART_0_IRQ 1
#define JTAG_UART_0_IRQ_INTERRUPT_CONTROLLER_ID 0
#define JTAG_UART_0_NAME "/dev/jtag_uart_0"
#define JTAG_UART_0_READ_DEPTH 64
#define JTAG_UART_0_READ_THRESHOLD 8
#define JTAG_UART_0_SPAN 8
#define JTAG_UART_0_TYPE "altera_avalon_jtag_uart"
#define JTAG_UART_0_WRITE_DEPTH 64
#define JTAG_UART_0_WRITE_THRESHOLD 8


/*
 * mm_bridge_0 configuration
 *
 */

#define ALT_MODULE_CLASS_mm_bridge_0 altera_avalon_mm_bridge
#define MM_BRIDGE_0_BASE 0x41000
#define MM_BRIDGE_0_IRQ -1
#define MM_BRIDGE_0_IRQ_INTERRUPT_CONTROLLER_ID -1
#define MM_BRIDGE_0_NAME "/dev/mm_bridge_0"
#define MM_BRIDGE_0_SPAN 1024
#define MM_BRIDGE_0_TYPE "altera_avalon_mm_bridge"


/*
 * onchip_memory2_0 configuration
 *
 */

#define ALT_MODULE_CLASS_onchip_memory2_0 altera_avalon_onchip_memory2
#define ONCHIP_MEMORY2_0_ALLOW_IN_SYSTEM_MEMORY_CONTENT_EDITOR 1
#define ONCHIP_MEMORY2_0_ALLOW_MRAM_SIM_CONTENTS_ONLY_FILE 0
#define ONCHIP_MEMORY2_0_BASE 0x20000
#define ONCHIP_MEMORY2_0_CONTENTS_INFO ""
#define ONCHIP_MEMORY2_0_DUAL_PORT 0
#define ONCHIP_MEMORY2_0_GUI_RAM_BLOCK_TYPE "AUTO"
#define ONCHIP_MEMORY2_0_INIT_CONTENTS_FILE "uart_nios_onchip_memory2_0"
#define ONCHIP_MEMORY2_0_INIT_MEM_CONTENT 1
#define ONCHIP_MEMORY2_0_INSTANCE_ID "NONE"
#define ONCHIP_MEMORY2_0_IRQ -1
#define ONCHIP_MEMORY2_0_IRQ_INTERRUPT_CONTROLLER_ID -1
#define ONCHIP_MEMORY2_0_NAME "/dev/onchip_memory2_0"
#define ONCHIP_MEMORY2_0_NON_DEFAULT_INIT_FILE_ENABLED 1
#define ONCHIP_MEMORY2_0_RAM_BLOCK_TYPE "AUTO"
#define ONCHIP_MEMORY2_0_READ_DURING_WRITE_MODE "DONT_CARE"
#define ONCHIP_MEMORY2_0_SINGLE_CLOCK_OP 0
#define ONCHIP_MEMORY2_0_SIZE_MULTIPLE 1
#define ONCHIP_MEMORY2_0_SIZE_VALUE 102400
#define ONCHIP_MEMORY2_0_SPAN 102400
#define ONCHIP_MEMORY2_0_TYPE "altera_avalon_onchip_memory2"
#define ONCHIP_MEMORY2_0_WRITABLE 1


/*
 * pio_0 configuration
 *
 */

#define ALT_MODULE_CLASS_pio_0 altera_avalon_pio
#define PIO_0_BASE 0x41440
#define PIO_0_BIT_CLEARING_EDGE_REGISTER 0
#define PIO_0_BIT_MODIFYING_OUTPUT_REGISTER 0
#define PIO_0_CAPTURE 0
#define PIO_0_DATA_WIDTH 8
#define PIO_0_DO_TEST_BENCH_WIRING 0
#define PIO_0_DRIVEN_SIM_VALUE 0
#define PIO_0_EDGE_TYPE "NONE"
#define PIO_0_FREQ 120000000
#define PIO_0_HAS_IN 0
#define PIO_0_HAS_OUT 1
#define PIO_0_HAS_TRI 0
#define PIO_0_IRQ -1
#define PIO_0_IRQ_INTERRUPT_CONTROLLER_ID -1
#define PIO_0_IRQ_TYPE "NONE"
#define PIO_0_NAME "/dev/pio_0"
#define PIO_0_RESET_VALUE 0
#define PIO_0_SPAN 16
#define PIO_0_TYPE "altera_avalon_pio"


/*
 * timer_0 configuration
 *
 */

#define ALT_MODULE_CLASS_timer_0 altera_avalon_timer
#define TIMER_0_ALWAYS_RUN 1
#define TIMER_0_BASE 0x41420
#define TIMER_0_COUNTER_SIZE 32
#define TIMER_0_FIXED_PERIOD 1
#define TIMER_0_FREQ 120000000
#define TIMER_0_IRQ 0
#define TIMER_0_IRQ_INTERRUPT_CONTROLLER_ID 0
#define TIMER_0_LOAD_VALUE 119999
#define TIMER_0_MULT 0.001
#define TIMER_0_NAME "/dev/timer_0"
#define TIMER_0_PERIOD 1
#define TIMER_0_PERIOD_UNITS "ms"
#define TIMER_0_RESET_OUTPUT 0
#define TIMER_0_SNAPSHOT 0
#define TIMER_0_SPAN 32
#define TIMER_0_TICKS_PER_SEC 1000
#define TIMER_0_TIMEOUT_PULSE_OUTPUT 0
#define TIMER_0_TIMER_DEVICE_TYPE 1
#define TIMER_0_TYPE "altera_avalon_timer"


/*
 * uart_0 configuration
 *
 */

#define ALT_MODULE_CLASS_uart_0 altera_avalon_uart
#define UART_0_BASE 0x41400
#define UART_0_BAUD 115200
#define UART_0_DATA_BITS 8
#define UART_0_FIXED_BAUD 1
#define UART_0_FREQ 120000000
#define UART_0_IRQ 2
#define UART_0_IRQ_INTERRUPT_CONTROLLER_ID 0
#define UART_0_NAME "/dev/uart_0"
#define UART_0_PARITY 'N'
#define UART_0_SIM_CHAR_STREAM ""
#define UART_0_SIM_TRUE_BAUD 0
#define UART_0_SPAN 32
#define UART_0_STOP_BITS 1
#define UART_0_SYNC_REG_DEPTH 2
#define UART_0_TYPE "altera_avalon_uart"
#define UART_0_USE_CTS_RTS 0
#define UART_0_USE_EOP_REGISTER 0

#endif /* __SYSTEM_H_ */
