SimonKohler88/esl1_fpga_fir/quartus_proj_max10/ip/core_sdram_axi4/sdram_axi.v

//-----------------------------------------------------------------
//                    SDRAM Controller (AXI4)
//                           V1.0
//                     Ultra-Embedded.com
//                     Copyright 2015-2019
//
//                 Email: admin@ultra-embedded.com
//
//                         License: GPL
// If you would like a version with a more permissive license for
// use in closed source commercial applications please contact me
// for details.
//-----------------------------------------------------------------
//
// This file is open source HDL; you can redistribute it and/or 
// modify it under the terms of the GNU General Public License as 
// published by the Free Software Foundation; either version 2 of 
// the License, or (at your option) any later version.
//
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
//-----------------------------------------------------------------
//                          Generated File
//-----------------------------------------------------------------

module sdram_axi
#(
    //-----------------------------------------------------------------
    // Key Params
    //-----------------------------------------------------------------
     parameter SDRAM_MHZ              = 100
    ,parameter SDRAM_BANKS            = 4
    ,parameter SDRAM_COL_W            = 8
    ,parameter SDRAM_ROW_W            = 12
    ,parameter SDRAM_ADDR_W           = 23
    ,parameter SDRAM_CAS_LATENCY      = 3
    ,parameter SDRAM_START_DELAY_US   = 200
    ,parameter SDRAM_TRCD_NS          = 15
    ,parameter SDRAM_TRP_NS           = 15
    ,parameter SDRAM_TRFC_NS          = 60
)
(
    // Inputs
     input           clk_i
    ,input           rst_i
    ,input           inport_awvalid_i
    ,input  [SDRAM_ADDR_W-1:0]  inport_awaddr_i
    ,input  [  3:0]  inport_awid_i
    ,input  [  7:0]  inport_awlen_i
    ,input  [  1:0]  inport_awburst_i
    ,input           inport_wvalid_i
    ,input  [ 31:0]  inport_wdata_i
    ,input  [  3:0]  inport_wstrb_i
    ,input           inport_wlast_i
    ,input           inport_bready_i
    ,input           inport_arvalid_i
    ,input  [SDRAM_ADDR_W-1:0]  inport_araddr_i
    ,input  [  3:0]  inport_arid_i
    ,input  [  7:0]  inport_arlen_i
    ,input  [  1:0]  inport_arburst_i
    ,input           inport_rready_i
    ,input  [  2:0]  inport_arsize_i
    ,input  [  2:0]  inport_awsize_i
    //,input  [ 15:0]  sdram_data_input_i

    // Outputs
    ,output          inport_awready_o
    ,output          inport_wready_o
    ,output          inport_bvalid_o
    ,output [  1:0]  inport_bresp_o
    ,output [  3:0]  inport_bid_o
    ,output          inport_arready_o
    ,output          inport_rvalid_o
    ,output [ 31:0]  inport_rdata_o
    ,output [  1:0]  inport_rresp_o
    ,output [  3:0]  inport_rid_o
    ,output          inport_rlast_o
    ,output          sdram_clk_o
    ,output          sdram_cke_o
    ,output          sdram_cs_o
    ,output          sdram_ras_o
    ,output          sdram_cas_o
    ,output          sdram_we_o
    ,output [  1:0]  sdram_dqm_o
    ,output [ 11:0]  sdram_addr_o
    ,output [  1:0]  sdram_ba_o
    //,output [ 15:0]  sdram_data_output_o
    //,output          sdram_data_out_en_o
    
    //inouts
    ,inout [ 15:0]  sdram_dq_io
);


//-----------------------------------------------------------------
// AXI Interface
//-----------------------------------------------------------------
wire [ 31:0]  ram_addr_w;
wire [  3:0]  ram_wr_w;
wire          ram_rd_w;
wire          ram_accept_w;
wire [ 31:0]  ram_write_data_w;
wire [ 31:0]  ram_read_data_w;
wire [  7:0]  ram_len_w;
wire          ram_ack_w;
wire          ram_error_w;

wire [ 31:0]  tmp_awaddr = {9'b0, inport_awaddr_i};
wire [ 31:0]  tmp_araddr = {9'b0, inport_araddr_i};

wire          sdram_data_out_en_o;
wire [ 15:0]  sdram_data_output_o;
wire [ 15:0]  sdram_data_input_i;
assign sdram_dq_io        = sdram_data_out_en_o ? sdram_data_output_o : 'bz;
assign sdram_data_input_i = sdram_dq_io;

sdram_axi_pmem
u_axi
(
    .clk_i(clk_i),
    .rst_i(rst_i),

    // AXI port
    .axi_awvalid_i(inport_awvalid_i),
    .axi_awaddr_i(tmp_awaddr),
    .axi_awid_i(inport_awid_i),
    .axi_awlen_i(inport_awlen_i),
    .axi_awburst_i(inport_awburst_i),
    .axi_wvalid_i(inport_wvalid_i),
    .axi_wdata_i(inport_wdata_i),
    .axi_wstrb_i(inport_wstrb_i),
    .axi_wlast_i(inport_wlast_i),
    .axi_bready_i(inport_bready_i),
    .axi_arvalid_i(inport_arvalid_i),
    .axi_araddr_i(tmp_araddr),
    .axi_arid_i(inport_arid_i),
    .axi_arlen_i(inport_arlen_i),
    .axi_arburst_i(inport_arburst_i),
    .axi_rready_i(inport_rready_i),
    .axi_awready_o(inport_awready_o),
    .axi_wready_o(inport_wready_o),
    .axi_bvalid_o(inport_bvalid_o),
    .axi_bresp_o(inport_bresp_o),
    .axi_bid_o(inport_bid_o),
    .axi_arready_o(inport_arready_o),
    .axi_rvalid_o(inport_rvalid_o),
    .axi_rdata_o(inport_rdata_o),
    .axi_rresp_o(inport_rresp_o),
    .axi_rid_o(inport_rid_o),
    .axi_rlast_o(inport_rlast_o),
    
    // RAM interface
    .ram_addr_o(ram_addr_w),
    .ram_accept_i(ram_accept_w),
    .ram_wr_o(ram_wr_w),
    .ram_rd_o(ram_rd_w),
    .ram_len_o(ram_len_w),
    .ram_write_data_o(ram_write_data_w),
    .ram_ack_i(ram_ack_w),
    .ram_error_i(ram_error_w),
    .ram_read_data_i(ram_read_data_w)
);

//-----------------------------------------------------------------
// SDRAM Controller
//-----------------------------------------------------------------
sdram_axi_core
#(
     .SDRAM_MHZ(SDRAM_MHZ)
    ,.SDRAM_BANKS(SDRAM_BANKS)
    ,.SDRAM_COL_W(SDRAM_COL_W)
    ,.SDRAM_ROW_W(SDRAM_ROW_W)
    ,.SDRAM_ADDR_W(SDRAM_ADDR_W)
    ,.SDRAM_CAS_LATENCY(SDRAM_CAS_LATENCY)
    ,.SDRAM_START_DELAY_US(SDRAM_START_DELAY_US)
    ,.SDRAM_TRCD_NS(SDRAM_TRCD_NS)
    ,.SDRAM_TRP_NS(SDRAM_TRP_NS)
    ,.SDRAM_TRFC_NS(SDRAM_TRFC_NS)
)
u_core
(
     .clk_i(clk_i)
    ,.rst_i(rst_i)

    ,.inport_wr_i(ram_wr_w)
    ,.inport_rd_i(ram_rd_w)
    ,.inport_len_i(ram_len_w)
    ,.inport_addr_i(ram_addr_w)
    ,.inport_write_data_i(ram_write_data_w)
    ,.inport_accept_o(ram_accept_w)
    ,.inport_ack_o(ram_ack_w)
    ,.inport_error_o(ram_error_w)
    ,.inport_read_data_o(ram_read_data_w)

    ,.sdram_clk_o(sdram_clk_o)
    ,.sdram_cke_o(sdram_cke_o)
    ,.sdram_cs_o(sdram_cs_o)
    ,.sdram_ras_o(sdram_ras_o)
    ,.sdram_cas_o(sdram_cas_o)
    ,.sdram_we_o(sdram_we_o)
    ,.sdram_dqm_o(sdram_dqm_o)
    ,.sdram_addr_o(sdram_addr_o)
    ,.sdram_ba_o(sdram_ba_o)
    ,.sdram_data_output_o(sdram_data_output_o)
    ,.sdram_data_out_en_o(sdram_data_out_en_o)
    ,.sdram_data_input_i(sdram_data_input_i)
);



endmodule
