SimonKohler88/esl1_fpga_fir/(commit log)

2025-11-02 base project and nios for uart
2025-11-02 working nios with uart over jtag, leds over AV MM
2025-11-09 timer isr, jtag isr, console working wy better
2025-11-09 Erster Entwurf FIR Filter Thomas
2025-11-09 implemented IOS for Audio, interface to fir filter
2025-11-09 Erstelle cmake um in Clion automatisch die Testbenches zu erstellen und zu simulieren.
2025-11-09 preload a standard set of filter coefficients at startup
2025-11-10 CMakeLists.txt verbessert, dass gtkwave gleich nach der Simulation startet
2025-11-10 Umsetzung Filter zum Zweiten
2025-11-11 switch to normal uart
2025-11-11 change to use normal uart
2025-11-11 REALLY corrected Address issue
    [hello_world.c, main.py, system.h, uart.vhdl]
2025-11-17 Added filter computation and write
    The 64 filter coefficients can be computed and written to the FPGA by defining the cutoff frequency(s) and filter type.
2026-02-25 kicad layout, max10 prj
    [31-6575.stp, D0008A.stp, D0014A.stp, DBV0006A.stp, DDC0006A.stp, DGS0010A.stp, R_8_ADI.step, SOT23-6L_STM.step]
2026-02-25 add dac interface, cleanup led stuff
2026-02-27 adding mcu spi interface, fir bypass mux
    [bom.xlsx]
2026-03-01 add basic esp32 project
    [nvs.csv, partitions.csv]
2026-03-26 production gerber files
    [bom.csv, designators.csv, positions.csv, v1.kicad_pcb, v1_frontpanel.kicad_pcb]
